makeOurCity/parking-status-sensor/hardware/lte-power-switch/renders/board-top.png

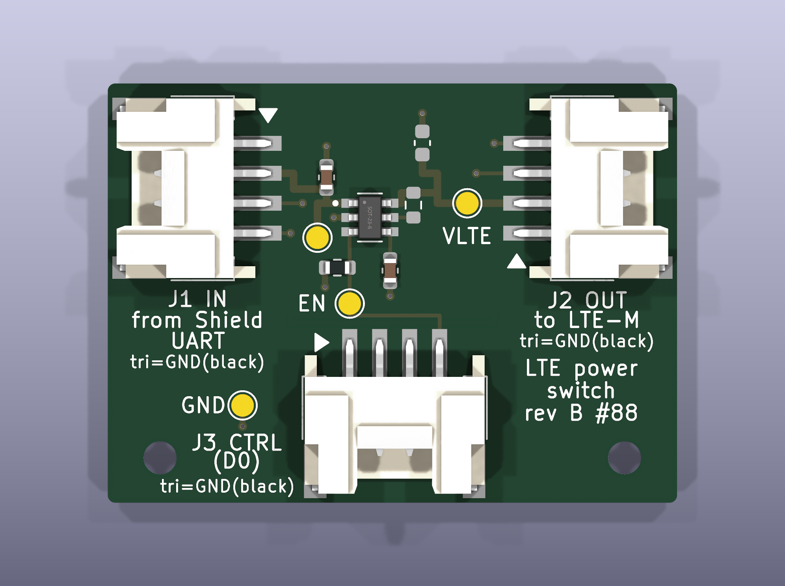
hardware/lte-power-switch/renders/board-top.png
