makeOurCity/parking-status-sensor/tools/ipad-sign-simulator/reference/full.png

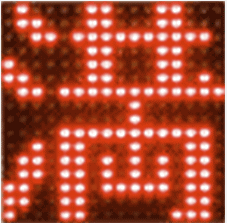
tools/ipad-sign-simulator/reference/full.png
