makeOurCity/parking-status-sensor/infra/README.md

# AWS IoT Core プロビジョニング（Issue #4）

[docs/iot-core.md](../docs/iot-core.md) の設計に沿って、IoT Core・Lambda スタブ・Cognito・LoRaWAN をセットアップするスクリプト群。

**組織の AWS アカウント**: この PoC 専用のアカウントに、これらのスクリプトで構築した（#98）。構成・必要な権限・権限の使い分け（確認は ReadOnly、作成は PowerUser、IAM ロールを作る手順は Admin）は [docs/aws-admin-handoff.md](../docs/aws-admin-handoff.md)。

## 前提

- [AWS CLI v2](https://docs.aws.amazon.com/cli/latest/userguide/getting-started-install.html)
- `jq`（`setup.sh` / `provision-device.sh` で使用）
- `zip`（`deploy-bridge-stub.sh` で使用）
- IAM 権限: IoT Core（Thing / Policy / Rule）、Lambda、IAM ロール作成、CloudWatch Logs

**アカウントの切り替え**: 開発者の個人 AWS アカウント（移行元。LTE-M 端末の切り替えまで残る）と組織アカウントは、`config.env` / `config.org.env` と `CONFIG_FILE` で切り替える。`EXPECTED_ACCOUNT_ID` が違えば何も作らずに中断する。

## 設定（`config.env`）

- **`EXPECTED_ACCOUNT_ID`（必須）**: 実行先の AWS アカウント ID（12 桁）。クレデンシャルが指すアカウントと違えば、すべてのスクリプトが何も作らずに中断する（旧アカウントと組織アカウントの取り違え防止、#98）
- **`AWS_PROFILE`（省略可）**: 未設定なら環境変数のクレデンシャルを使う。書き込み用（Power User）と確認用（ReadOnly）を使い分けるときは、`config.env` には書かず `AWS_PROFILE=<profile> ./verify.sh` のように実行時に渡す
- **`CONFIG_FILE`（環境変数）**: 設定ファイルを切り替える（相対パスは `infra/` から）。旧アカウントと組織アカウントを並べるとき: `CONFIG_FILE=config.org.env ./setup.sh`（`config.*.env` も Git 管理外）
- **`DEVICE_MASTER_TABLE` / `ORION_URL` / `ORION_FIWARE_SERVICE` / `ORION_FIWARE_SERVICEPATH` / `ORION_COGNITO_*`（省略可）**: Lambda の環境変数になる（#7）。`ORION_URL` が空なら Lambda は Orion に送らない。デプロイのたびに環境変数を `config.env` の内容で作り直すので、Orion の接続先を変えるときは `config.env` を直して `./deploy-bridge-stub.sh` を再実行する。Orion のトークンは有効期限があるため、Lambda が送るたびに Cognito（SRP。`USER_SRP_AUTH`）でログインして取る。`ORION_COGNITO_USER_POOL_ID` / `_CLIENT_ID` / `_USERNAME` / `_PASSWORD` の 4 つをそろえて設定する（`_CLIENT_SECRET` / `_TOKEN_TYPE` は省略可。リージョンは User Pool ID の先頭から決まる）。パスワードは `config.env` に書かず、`./deploy-bridge-stub.sh` の実行時に端末で入力するのを勧める（入力は画面に出ない。Lambda に設定済みの値があり、`USER_POOL_ID`・`CLIENT_ID`・`USERNAME` が同じなら、2 回目以降は入力不要で引き継ぐ。変えるときは `./deploy-bridge-stub.sh --ask-password`）。パスワードは Lambda の設定（環境変数）には入るので、Orion に書き込むだけの専用ユーザーにする。`./verify.sh` は設定済みかどうかだけを表示し、パスワードの値は出さない
- **`LOG_RETENTION_DAYS`（省略可。既定 400）**: Lambda のロググループの保持期間（日）。約 1 年。400 日は、iOS ログビューアのリセット時刻クエリが過去 400 日分を見ることに合わせた値で、CloudWatch Logs が受け付ける値のひとつ（365 なら 1 年ちょうど）。`setup.sh` がロググループ（無ければ作成）に設定し、`verify.sh` が確認する。空にすると設定しない（無期限）
- **`LAMBDA_ROLE_ARN` / `COGNITO_AUTH_ROLE_ARN` / `LORAWAN_ROLE_ARN`（省略可）**: IAM ロールを管理者が用意した場合の ARN。指定するとスクリプトはロールを作らず、そのロールを使う。Power User 権限では IAM ロールの作成も PassRole もできないため（#98）。ロールの定義は [docs/aws-admin-handoff.md](../docs/aws-admin-handoff.md)

## 手順

```bash
cd infra
cp config.env.example config.env   # EXPECTED_ACCOUNT_ID・リージョン等を編集
chmod +x *.sh lib.sh

./setup.sh                         # ポリシー + デバイスマスターのテーブル + Lambda + IoT ルール
./verify.sh                        # リソース確認
./provision-device.sh xiao-e83dc1fb05fc   # 端末1台分の Thing + 証明書
./test-publish.sh xiao-e83dc1fb05fc       # CLI から疎通確認
```

`provision-device.sh` は証明書を `firmware/certs/` に書き出し、`secrets.h` 用の設定値を表示する。

## スクリプト一覧

| スクリプト | 内容 |
|---|---|
| `setup.sh` | 一括セットアップ（ポリシー・ルール 2 本（端末テレメトリ / LoRaWAN）・Lambda）。何度実行しても同じ結果になる |
| `verify.sh` | セットアップ後のリソース存在確認 |
| `provision-device.sh` | Thing + 証明書を端末1台分登録 |
| `test-publish.sh` | AWS CLI からサンプルペイロードを publish |
| `deploy-bridge-stub.sh` | Lambda のみデプロイ（`bridge/` のモジュールを zip 化。Lambda の環境変数を `config.env` の `DEVICE_MASTER_TABLE` / `ORION_*` から設定。実行ロールには LoRaWAN 用 `iotwireless:GetWirelessDevice` とデバイスマスター用 `dynamodb:GetItem` を付与。`LAMBDA_ROLE_ARN` 指定時はロールを作らない（権限は管理者が付ける）） |
| `setup-device-master.sh` | デバイスマスター（deviceId → name / location）の DynamoDB テーブルを作る（#7, #14。プロビジョンド 1 RCU / 1 WCU）。`setup.sh` からも呼ばれる |
| `device-master.sh` | デバイスマスターの登録・確認・削除（`put <deviceId> <name> <lat> <lon> [--disabled]` / `list` / `get` / `delete`）。登録のない deviceId は Orion に書かれないので、`test-publish.sh` で Orion まで流したいときは先に `put` する |
| `setup-cognito.sh` | iOS ログビューアアプリ向け Cognito User Pool / Identity Pool / IAM ロール（CloudWatch Logs とデバイスマスターの読み取り専用）を一括作成（[docs/ios-app-cognito.md](../docs/ios-app-cognito.md)）。`--pools-only` で Identity Pool までで止め、管理者に渡すトラストポリシーを表示する。`COGNITO_AUTH_ROLE_ARN` 指定時はロールを作らず割り当てのみ |
| `verify-cognito.sh` | Cognito セットアップ後のリソース存在確認 |
| `setup-lorawan.sh` | IoT Core for LoRaWAN の `role`（Destination とゲートウェイが使う IAM ロール。IAM 権限が要る）、`profiles`（Service / Device Profile・Destination）、`gateway`（ゲートウェイ登録と CUPS 証明書。`--rotate` で再発行）、`device <deviceId>`（Wireless Device）。#98 |
| `verify-lorawan.sh` | LoRaWAN リソースの存在確認とゲートウェイの接続状態（読み取りのみ） |

`verify*.sh` は読み取り系の呼び出しだけなので、ReadOnly 権限のプロファイルで実行できる。

## LoRaWAN（Issue #40, #98）

[docs/40-lorawan-design.md](../docs/40-lorawan-design.md) の構成を、スクリプトで再現する。

```bash
./setup-lorawan.sh role                      # IAM ロール IoTWirelessGatewayCertManagerRole（IAM のロール作成と PassRole が要る権限で）
./setup-lorawan.sh profiles                  # Service Profile / Device Profile / Destination
./setup-lorawan.sh profiles --no-destination # ロール不要の Service / Device Profile だけ（Destination は後で）
./setup-lorawan.sh gateway                   # ゲートウェイ登録 + cups.{uri,trust,crt,key} を gateway-certs/ に出力
LORAWAN_DEV_EUI=<16桁> LORAWAN_APP_EUI=<16桁> \
  ./setup-lorawan.sh device <deviceId>       # AppKey は対話入力（履歴に残らない）
./verify-lorawan.sh <deviceId>
```

- Destination は IAM ロール（既定 `IoTWirelessGatewayCertManagerRole`）を使う。`role` で作れる（IAM 権限が要る。Power User では作れないので、その場合は管理者に作ってもらう）
- **ゲートウェイ EUI は他の AWS アカウントに登録済みだと作れない**。アカウント移行では、旧アカウントでゲートウェイを削除してから `gateway` を実行する
- `gateway-certs/` は Git 管理外。`cups.key` は秘密鍵で、再ダウンロードできない（紛失したら `gateway --rotate`）
- SenseCAP M2 側の設定（ローカルコンソール > LoRa > LoRa Network）は `gateway` の実行後に表示される手順に従う

## iOS ログビューアアプリ向け Cognito（Issue #68）

```bash
cd infra
./setup-cognito.sh     # User Pool + App Client + Identity Pool + IAM ロールを作成
./verify-cognito.sh    # リソース確認
```

`config.env` の `IOS_APP_USER_EMAIL` で指定したメールアドレスを Cognito ユーザー名として、ログイン用ユーザーを1名作成する（開発者本人のみ想定）。IAM ロールは `CLOUDWATCH_LOG_GROUP_NAME` で指定したロググループの読み取り専用に限定される。詳細設計は [docs/ios-app-cognito.md](../docs/ios-app-cognito.md) を参照。

## Basic Ingest

`config.env` の `USE_BASIC_INGEST=1`（デフォルト）で、端末は次のトピックへ publish する。

```
$aws/rules/parking_status_telemetry/parking-status/{deviceId}/telemetry
```

メッセージング課金を回避できる。詳細は [docs/iot-core.md](../docs/iot-core.md)。

## 関連 Issue

- [#4](https://github.com/makeOurCity/parking-status-sensor/issues/4) 接続基盤
- [#6](https://github.com/makeOurCity/parking-status-sensor/issues/6) ファームウェア TLS 対応
- [#7](https://github.com/makeOurCity/parking-status-sensor/issues/7) Lambda 本実装
