makeOurCity/parking-status-sensor/docs/schematic.md

# 回路図（Wi-Fi 第1弾）

Issue #11。試作1台の電気回路。部品表は [bom.md](bom.md)、組み立て手順は [wiring.md](wiring.md)。

- **図面種別**: 単線図 / 複線図 / 回路図
- **対象**: XIAO ESP32S3 + Grove Shield + Grove I2C Color Sensor V3.0 + LiPo
- **対象外**: LTE-M（Wi-Fi 不可現場で追加）、筐体（#14）
- **電圧**: DC 3.7 V（LiPo）→ Shield / XIAO 内蔵レギュレータ → DC 3.3 V 系統

---

## 図面記号・機器記号一覧

| 記号 | 機器 | 型番・備考 |
|---|---|---|
| BT1 | 二次電池（LiPo） | 3.7 V / 4,400 mAh、保護回路内蔵 |
| J1 | コネクタ | JST-PH 2.0（2極）、Grove Shield BAT 用 |
| J2 | コネクタ | Grove 4芯（Shield I2C ポート） |
| J3 | コネクタ | Grove 4芯（Grove Color Sensor V3.0 内蔵） |
| U0 | 拡張シールド | Grove Shield for XIAO（103020312） |
| U1 | マイコンモジュール | Seeed XIAO ESP32S3（U0 に装着） |
| U2 | カラーセンサモジュール | Grove I2C Color Sensor V3.0（VEML6040、I2C `0x10`） |
| C1 | 電解コンデンサ | 470 µF / 16 V |

端子名は XIAO・Shield・Grove モジュール実装のラベルに合拠する。Grove ケーブルは標準ピン配置のまま接続する（[wiring.md §3](wiring.md)）。

---

## 1. 単線図

系統と機能ブロックの関係。低圧 DC 電子機器としての単線表現。

```
                    ┌──────────────────────────────────────────┐
   情報系（論理）    │  [満空灯] → 光 → [U2 色検出]            │
                    │              ↑ I2C (Grove)              │
                    │    [U1+U0 判定・MQTT]                   │
                    │              │ Wi-Fi                    │
                    │              ↓                          │
                    │         [クラウド / FIWARE]              │
                    └──────────────────────────────────────────┘

                    ┌──────────────────────────────────────────┐
   電力系（物理）    │                                          │
                    │   BT1 ──→ U0（BAT・充電管理）──→ U1      │
                    │              │                            │
                    │              ├── 3.3 V 系統 ──→ U2       │
                    │              │         └── C1            │
                    │              └── USB-C（充電・開発用）    │
                    └──────────────────────────────────────────┘
```

| 系統 | 電圧・媒体 | 経路 |
|---|---|---|
| 主電源 | DC 3.7 V | BT1 → J1 → U0 BAT → U1 |
| 制御電源 | DC 3.3 V | U0/U1 LDO → 3V3 系統 → U2 |
| 通信（センサ） | I2C（Grove） | U0 I2C ↔ J2—J3 ↔ U2 |
| 通信（外部） | Wi-Fi 2.4 GHz | U1 内蔵アンテナ |

---

## 2. 複線図

全配線を線番で示す。Grove ケーブル内の線色は Seeed 標準（両端とも標準配置）。

| 線番 | 色 | 起点端子 | 終点端子 | 備考 |
|---|---|---|---|---|
| W1 | 赤 | BT1 (+) | J1-1 → U0 BAT+ | 極性確認必須 |
| W2 | 黒 | BT1 (−) | J1-2 → U0 BAT− | 同上 |
| W3 | 黄 | U0 I2C SCL | J2 → J3 → U2 SCL | Grove 標準 |
| W4 | 白 | U0 I2C SDA | J2 → J3 → U2 SDA | Grove 標準 |
| W5 | 赤 | U0 I2C VCC | J2 → J3 → U2 VCC | Grove 標準 |
| W6 | 黒 | U0 I2C GND | J2 → J3 → U2 GND | Grove 標準 |
| W7 | — | U0 3V3 | C1 (+) | Shield 近傍 |
| W8 | — | U0 GND | C1 (−) | 電解コンデンサ極性に注意 |

```
  BT1              J1          U0 (Shield)        J2    Groveケーブル    J3      U2
  ┌─┐            ┌─┴─┐    ┌─────────────┐       ┌─┴─┐   ═══════════   ┌─┴─┐  ┌────────────┐
  │+├─ W1 赤 ────┤ 1 ├────┤ BAT+        │       │黄 ├─ W3 SCL ────────┤黄 ├────┤ Grove SCL  │
  │-├─ W2 黒 ────┤ 2 ├────┤ BAT-        │       │白 ├─ W4 SDA ────────┤白 ├────┤ Grove SDA  │
  └─┘            └───┘    │ I2C Grove   │       │赤 ├─ W5 VCC ────────┤赤 ├────┤ Grove VCC  │
                            │  ┌─ U1 ─┐  │       │黒 ├─ W6 GND ────────┤黒 ├────┤ Grove GND  │
                            │  │XIAO  │  │       └───┘               └───┘  │ VEML6040   │
                            │  └──────┘  │                                   └────────────┘
                            │ W7   W8    │
                            └─┬────┬─────┘
                              │    │
                             ┌┴────┴┐
                             │  C1  │
                             │ 470µF│
                             └──────┘

  脱着点: J2 ↔ J3（Grove コネクタ）またはセンサパッチ全体
```

---

## 3. 回路図

電子回路としての接続。部品記号は一般的な回路図記法に準じる。

### 3.1 電源部

```
                        USB-C（開発・充電時）
                            │
                            ▼
    ┌───┐   W1    ┌───┐   ┌─────────────────────────────┐
    │   ├─────────┤ J1├───┤ BAT+          U0            │
    │BT1│   W2    │2P │   │ Grove Shield for XIAO       │
    │   ├─────────┤   ├───┤ BAT-                        │
    └───┘           └───┘   │  ┌─ 充電管理 ─┐           │
     3.7V                    │  │    U1 XIAO ESP32S3    │
                             │  └──────┬─────┘           │
                             │         │ 3.3V LDO        │
                             │        ┌┴┐                │
                             │    3V3 ┤   ├───────────┬───┼──→ W5 (3.3V 系統)
                             │        └┬┘           │   │
                             │         │            │   │
                             │       GND├────────────┼───┼──→ W6 (GND 系統)
                             └─────────┼────────────────┘
                                       │
                                      ⊥ GND

    3.3V 系統 ──┬── W5 ──────────────────────────→ （後段 U2 へ）
                │
               ┌┴┐
               │ │ C1  470µF / 16V  （W7, W8）
               └┬┘
                │
               GND
```

### 3.2 I2C センサ部（U2）

```
    3.3V 系統 ──── W5 ────┬── U2 VCC
                          │
                         ┌┴┐  （U2 基板内蔵: バイパス、
                         │ │   I2C プルアップ抵抗）
    GND ──────── W6 ─────┴── U2 GND

    U0/U1 SDA (D4) ── W4 ── U2 SDA ──┐
                                      ├── I2C バス
    U0/U1 SCL (D5) ── W3 ── U2 SCL ──┘
                                      アドレス: 0x10
```

### 3.3 統合回路図

```
                                    ┌─────────────────────────────────┐
                                    │  U0 Grove Shield + U1 XIAO      │
    ┌───┐      ┌───┐                  │                                 │
    │BT1├─W1W2─┤J1 ├─────────────────┤ BAT+ / BAT-                    │
    └───┘      └───┘                  │                                 │
     3.7V                             │  I2C Grove ── W3〜W6 ────┐     │
                                      │  3V3 ─────┬──── W5 ──┐ │     │
                                      │  GND ─────┼──── W6 ──┐│ │     │
                                      │             │  C1   ││ │     │
                                      │             │ 470µF ││ │     │
                                      │             └──┬────┘│ │     │
                                      └──────────────────┼─────┼─┼─┘
                                                         │     │ │
                        ┌───┐   Grove 4芯      ┌───┐   │     │ │
                        │J2 ├─── W3〜W6 ────────┤J3 ├───┘     │ │
                        └───┘   (50〜100cm)    └─┬─┘         │ │
                                                 │ 脱着      │ │
                                                 ▼           ▼
                        ┌─────────────────────────────────────┴──┐
                        │  U2  Grove I2C Color Sensor V3.0         │
                        │  (VEML6040, Grove コネクタ内蔵)         │
                        └──────────────────────────────────────────┘
```

---

## 4. 端子台帳

### U0: Grove Shield for XIAO（使用端子）

| 端子 | 接続 | 線番 |
|---|---|---|
| BAT+ | J1-1 ← BT1 (+) | W1 |
| BAT− | J1-2 ← BT1 (−) | W2 |
| Grove I2C（黄） | SCL → U2 | W3 |
| Grove I2C（白） | SDA → U2 | W4 |
| Grove I2C（赤） | 3.3 V → U2 VCC | W5 |
| Grove I2C（黒） | GND → U2 | W6 |
| 3V3 | C1 (+) | W7 |
| GND | C1 (−) | W8 |

### U2: Grove I2C Color Sensor V3.0（使用端子）

Grove 標準ピン配置（J3 内蔵コネクタ）:

| Grove ピン | 線色 | 信号 | 線番 |
|---|---|---|---|
| 1 | 黄 | SCL | W3 |
| 2 | 白 | SDA | W4 |
| 3 | 赤 | VCC | W5 |
| 4 | 黒 | GND | W6 |

---

## 5. 設計メモ

| 項目 | 内容 |
|---|---|
| I2C アドレス | VEML6040: `0x10`（ファーム・スキャン時の確認値） |
| センサ出力 | R / G / B / W。MQTT・NGSIv2 の `clear` は W に対応 |
| Grove 配線 | ピン入替不要（旧 TCS34725 基板＋L字コネクタ構成から簡素化） |
| ファームウェア | VEML6040 ドライバ（`firmware/src/sensor.cpp`、Issue #5） |

詳細は [hardware.md](hardware.md)・[firmware/README.md](../firmware/README.md) を参照。
