makeOurCity/parking-status-sensor/hardware/lte-power-switch/renders/board-bottom.png

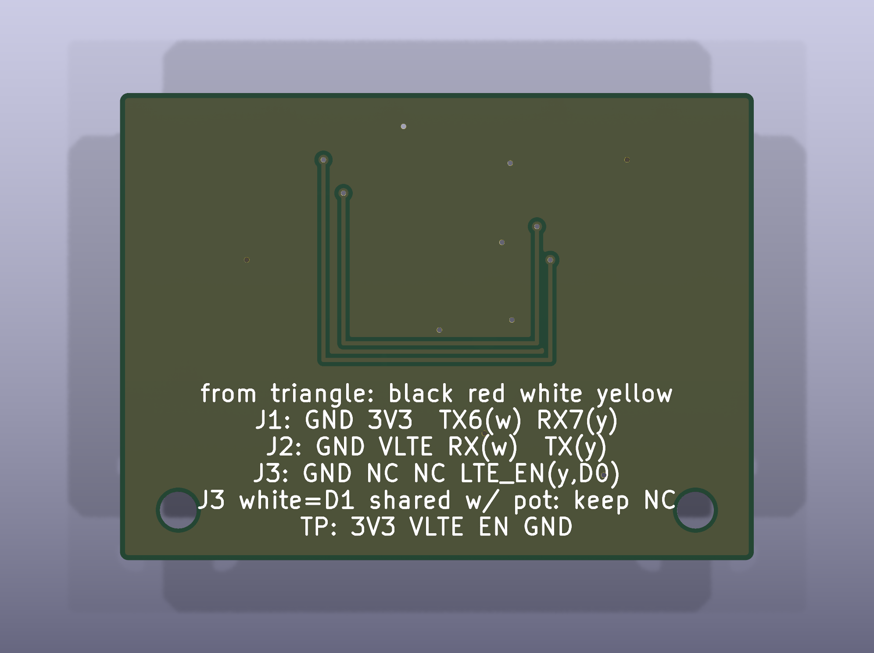
hardware/lte-power-switch/renders/board-bottom.png
