makeOurCity/parking-status-sensor/tools/ipad-sign-simulator/reference/empty.png

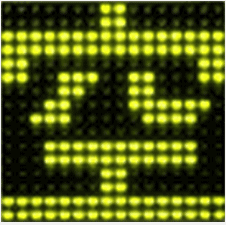
tools/ipad-sign-simulator/reference/empty.png
