makeOurCity/parking-status-sensor/docs/bom.md

# 詳細BOM（試作1台分）

Issue #11 のドラフト。Wi-Fi 第1弾 PoC 向けの部品リスト。

- **対象**: 試作1台。現場設置（LiPo・Grove センサ延長・黒シート積層固定）まで見据える
- **通信**: Wi-Fi のみ（LTE-M モジュール・SORACOM SIM は今回対象外）
- **電源**: LiPo 単体運用（自宅・オフィス等の既知 Wi-Fi でまず動作確認）
- **筐体**: 防水ケース・ケーブルグランドは #12（実寸確認後）

部品選定の経緯・将来の LTE-M 構成は [hardware.md](hardware.md) を参照。回路図は [schematic.md](schematic.md)、組み立て手順は [wiring.md](wiring.md)。

---

## 手持ち・キット類（棚卸し予定）

### Raspberry Pi センサーキット（未開封の可能性あり）

過去に購入した Raspberry Pi 向けセンサー・ケーブル等のまとめキットが手元にある見込み。箱の中身はこれから確認する。

キットに含まれていれば、本 BOM の以下と**重複する可能性**がある（あれば購入分は不要）:

- ジャンパ線（オス-メス / オス-オス）… DevKit ベンチ用
- ピンヘッダー・ブレッドボード
- その他汎用センサー（本 PoC では未使用）

重複があっても問題ない。余剰分はデバッグ用に使う。

### その他、手持ちで足りるもの

| 品目 | 用途 |
|---|---|
| USB-C データケーブル | 書き込み・デバッグ・LiPo 充電 |
| 熱収縮チューブ・ビニールテープ | 絶縁・JST はんだ箇所の strain relief |
| テスター | LiPo JST 極性確認、Grove ケーブル導通確認 |
| はんだごて・はんだ | JST・470µF 付け（センサモジュールへのはんだ不要） |

---

## 1. 電子部品

| # | 部品 | 型番・品番 | 数量 | 入手先 | 価格 | 備考 |
|---|---|---|---|---|---|---|
| 1 | マイコン | Seeed XIAO ESP32S3（無印）M-18078 | 1 | [秋月電子](https://akizukidenshi.com/catalog/g/gM-18078/) | ¥1,480 | ピンヘッダー非同梱。BAT はパッドのみ |
| 2 | Grove Shield | Grove Shield for XIAO 103020312 | 1 | [Seeed JP](https://jp.seeedstudio.com/Grove-Shield-for-Seeeduino-XIAO-p-4621.html) 等 | 約¥700 | I2C×2・UART×1・BAT パッド付き |
| 3 | カラーセンサ | Grove - I2C Color Sensor V3.0（101021133） | 1 | [Seeed Studio](https://www.seeedstudio.com/Grove-Color-Sensor-V3-0-p-5993.html) 等 | 約¥600 | VEML6040 搭載。Grove コネクタ内蔵 |
| 4 | バッテリー | LiPo 3.7V 4,400mAh JST-PH #15095 | 1 | [ストロベリーリナックス](https://strawberry-linux.com/catalog/items?code=15095) | ¥550 | 保護回路内蔵。接続前に極性確認 |
| 5 | 電解コンデンサ | 470μF 16V 16WXA470MEFC8X9 | 1 | [秋月電子](https://akizukidenshi.com/catalog/g/g108426/) | ¥10 | Wi-Fi 送信時の電圧降下対策。3V3-GND 間 |
| 6 | ピンヘッダー 1×40 | PH-1x40SG | 1 | [秋月電子](https://akizukidenshi.com/catalog/g/g100167/) | ¥35 | XIAO 用。14ピン分を切り出してはんだ付け（Shield 装着用） |
| 7 | JST-PH 2.0 メス + リード | PH2pin AWG24 約10cm 等 | 1 | [Amazon 等](https://www.amazon.co.jp/dp/B091JQS7BB) | ¥数百 | **Grove Shield BAT パッド**用。**2pin 版**を選ぶ |

### 今回対象外（将来・README 設計どおり）

| 部品 | 備考 |
|---|---|
| M5Stack SIM7080G CAT-M Unit（M5STACK-U128） | Wi-Fi 不可現場が出た時点で調達。Grove UART 接続 |
| SORACOM IoT SIM plan-D / plan-KM1 | 同上。動作確認済み |

---

## 2. 配線・コネクタ（Grove 統一）

### 2.1 センサ接続（Grove I2C）

XIAO + Grove Shield とセンサパッチ（Grove Color Sensor V3.0 + 黒シート積層）を **Grove 4芯ケーブル1本**で接続する。

| # | 部品 | 型番・品番 | 数量 | 入手先 | 価格 | 備考 |
|---|---|---|---|---|---|---|
| 8 | Grove 4芯ケーブル | 50cm / 100cm 等 | 1 | Seeed / Amazon 等 | 約¥200〜400 | 現場ごとに長さを選択。ピン入替不要 |

**Shield 側・センサ側とも** Grove 標準ピン配置のまま接続する（[wiring.md](wiring.md) §3）。

### 2.2 ジャンパ線（470µF 仮接続用・任意）

| # | 部品 | 数量 | 入手先 | 価格 | 備考 |
|---|---|---|---|---|---|
| 9 | ブレッドボード用ジャンパ線（オス-メス）15cm | 1パック | [秋月 103472](https://akizukidenshi.com/catalog/g/g103472/) | ¥330 | 470µF 仮接続用。Pi キットにあれば不要 |

**センサ延長は Grove ケーブルのみ。** ジャンパ線は 470µF 仮接続等に限定する。

## 3. 機構・その他

| # | 部品 | 数量 | 入手先 | 備考 |
|---|---|---|---|---|
| 11 | 透明テープ | 1 | ホームセンター / 100均 | 発光面全面固定（落下防止） |
| 12 | 黒カッティングシート | 1 | ホームセンター / 100均 | 遮光層。受光窓を切り抜く |
| 13 | 結束バンド | 適量 | ホームセンター | 配線整理 |

### #14 で扱う（今回の詳細BOMでは未確定）

| 部品 | 備考 |
|---|---|
| 防水ケース（IP65以上） | LiPo・Shield の実寸確認後に選定 |
| ケーブルグランド（M12/M16） | ケース選定と同時 |

---

## 4. 組み立て前チェックリスト

- [ ] Raspberry Pi センサーキットの棚卸し（重複部品の確認）
- [ ] XIAO にピンヘッダー（14ピン分）をはんだ付け
- [ ] XIAO を Grove Shield に装着
- [ ] Grove Shield の **BAT パッド**に JST-PH メスをはんだ付け（極性確認済み）
- [ ] LiPo を JST で接続し、USB 非接続で起動するか確認
- [ ] 黒カッティングシートに受光窓を切り、Grove Color Sensor V3.0 をセンサパッチとして貼付
- [ ] Grove ケーブルで Shield I2C ↔ センサを接続し、導通を確認
- [ ] 470µF を 3V3-GND 間に接続（はんだ付け推奨。ジャンパ仮接続でも可）

---

## 5. 費用見積（Wi-Fi 第1弾）

上記 #1〜#9 をすべて新規購入した場合の目安（ホームセンター品・手持ち工具は除く）。

| 区分 | 金額 |
|---|---|
| 電子部品（#1〜7） | 約 ¥3,400 |
| Grove 配線（#8） | 約 ¥400 |
| ジャンパ線（#9・任意） | 約 ¥330 |
| **試作1台 合計** | **約 ¥4,100** |

※ LTE-M モジュール・SIM を除く。README の約1.4〜1.5万円は LTE-M 込みの全体設計見積。Pi キットや手持ち部品で賄える分は上記から差し引く。

---

## 6. 未決事項（#14 へ）

- 防水ケースの具体型番・内部レイアウト
- ケーブルグランドのサイズ・個数
- LiPo 単体運用時の長期 Wi-Fi 送信における電源余裕の実測
- Raspberry Pi センサーキットの具体的な型番・同梱物リスト（棚卸し後に追記）
