makeOurCity/parking-status-sensor/hardware/lte-power-switch/fabrication/lte-power-switch-bom.csv

Comment | Designator | Footprint | LCSC Part #
TPS22918DBVR | U1 | SOT-23-6 | C131941
HY2.0-4P-WT | J1,J2,J3 | HY2.0-4P-WT_SMD-RA | C722729
1uF | C1 | C_0603_1608Metric | C15849
1nF | C2 | C_0603_1608Metric | C1588
100k | R1 | R_0603_1608Metric | C25803
