makeOurCity/parking-status-sensor/hardware/flame-sensor-case/grove-flame-sensor-case.3mf

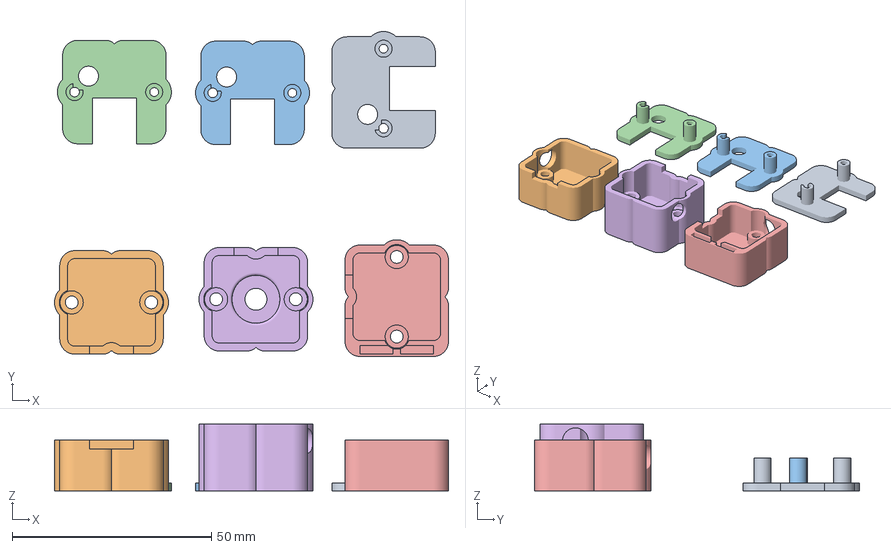
[picture p5: CAD file, 2026-10-07]
hardware/flame-sensor-case/grove-flame-sensor-case.3mf
99.0 x 81.6 x 16.8 mm
