makeOurCity/parking-status-sensor/docs/91-lorawan-failure-and-power.md

# Issue #91: LoRaWAN 版の失敗時の制限時間・バックオフと、消費電力の実測

対象Issue: https://github.com/makeOurCity/parking-status-sensor/issues/91

**種類: 作業記録ドキュメント（暫定・WIP）。** 途中経過は、まず #91 の Issue コメントに書き、区切りができたらこのファイルに反映して PR にする（AGENTS.md「ドキュメント運用」）。ファームの変更は本 PR に含めない（§4）。

## 1. 静的に読んだ内容の確認（2026-10-02、`main` = 0187a1c）

Issue 本文の「静的に読んだ結果」を、コードで確認した。実機での確認ではない。

| 項目 | 確認結果 | 該当箇所 |
|---|---|---|
| 接続フェーズの制限時間 | 各試行の**開始前**にしか確認しない。Join の最大待ち時間は固定で、残り時間では縮まらない | `transport.cpp` `connectTransportWithRetry`、`connectLoRaWan`、`wio_e5.cpp` `wioE5Join` |
| publish フェーズの制限時間 | 試行の開始前にしか確認しない。再 Join と送信のタイムアウトは固定 | `main.cpp` `publishWithRetry`、`reconnectTransport` → `connectLoRaWan` |
| Wio-E5 無応答時 | `wioE5Wake` は既定で 5 回 × 300ms = 約 1.5 秒で失敗する。`wioE5Join` と `wioE5SendConfirmedHex` は、それぞれ先頭で `wioE5Wake` を呼ぶ | `wio_e5.cpp` |
| バックオフ | なし（`ledgerRecordFailure` に記録するのみ） | `main.cpp` |
| `AT+RESET` | ファームに実装なし | `wio_e5.cpp` |

結論: Issue 本文の経路（接続に約 50 秒かけたあと、publish で再 Join と送信が重なり WDT の 80 秒を超える）は、コード上は成立する。ただし起こる確率は低く、実機で再現はしていない。

## 2. #87 との関係

- `fix/87-lte-modem-silent-watchdog-loop` には**設計書（`docs/87-lte-modem-silent-design.md`）だけ**があり、実装と PR はまだない（2026-10-02 時点）。
- #87 の設計では、`transport.h` に `deadlineAfter()` を置き、`connectTransport` などに hard deadline を渡す。`task_wdt` 起動のサイクルは送信せず失敗として記録する。バックオフは #89 の担当。
- そのため、#91 のファーム変更（LoRaWAN の Join・再 Join・送信の待ち時間の clamp）は、#87 の実装が入ってからその仕組みに載せて別 PR で行う。

## 3. 消費電力の実測（U200-1A）

方法: [power-measurement.md](power-measurement.md)、[tools/power-logger/README.md](../tools/power-logger/README.md) の**高速モード**（`logger-devkit-fast`）。LiPo → U200 IN/OUT → Grove Shield BAT、USB 非接続。

### 3.1 記録する個体情報

| 項目 | 記入 |
|---|---|
| 実施日 / 実施者 | 2026-10-02 / SAKAI Kazuki |
| 個体（デバイス ID） | |
| ファームの env | `xiao-s3-lorawan-pot`（実施者の申告。書き込んだ env は未確認。ログのどこかでブートログを確認できれば照合する） |
| ポットの接続 | 13:58:15 頃まで接続あり、以降は抜いた（ログの待機電流の段差から読んだ時刻、±数秒）。同じ 1 本のログ内で前後を比較した |
| LiPo の個体番号 / 開始時の電圧 | #1 / 約 4.07 V（ロガーの値） |
| Wio-E5 のファーム | 4.0.11（docs/40 で確認済み。要再確認） |
| ゲートウェイとの距離・環境 | |
| 電源投入の時刻（ログとの対応） | 13:22 頃（推定。ブートモード中の約 43 mA が 13:26 頃までに終わった観測から、約 4 分を引いた値）。ご自身の取得は 13:28 開始。取得したログは、ブートモード終了後の Deep Sleep 以降。Join と最初の送信は入っていない |

**ポットの影響（注意）:** docs/60 §10 の実測では、ポットを常時接続したままだと LTE-M 版の Deep Sleep 待機電流が 0.45 → 0.75 mA に増えた。LTE-M 版はリレーでポットの電源を切る構成（docs/60 §11）で、LoRaWAN 版はリレーを使わないため、ポットがつながっていれば常に給電される。`-pot` の値はブートモード中に NVS へ保存されるので、ブートモード終了後はケーブルを抜いても動作は変わらない。待機電流を測る目的では、**ポットをつないだ状態と外した状態の両方**を測るか、どちらで測ったかを記録する。

### 3.2 取りたい値（Issue の未測定項目に対応）

| 項目 | 値 | 出所（ログのどの区間か） |
|---|---|---|
| Deep Sleep 中の電流（ポットあり） | **0.847 mA**（中央値 0.81） | 13:28〜13:58 の約 28.7 分 |
| Deep Sleep 中の電流（ポットなし） | **0.487 mA**（中央値 0.43） | 13:58:30〜14:15 の約 16.1 分 |
| 起床だけで送信しないサイクル 1 回の mAh（Deep Sleep 分を除く） | **0.053 mAh**（0.052〜0.054、n=5） | 約 5.2 秒、約 36 mA が約 4.5 秒続く |
| 送信 1 回（Join 済み、ACK あり。状態を変えて起こした送信）を含む起床サイクルの mAh | **0.073 mAh**（0.071〜0.074、n=4） | 約 6.7 秒。送信なしより約 1.5 秒長く、その間約 45〜48 mA |
| 送信そのものの上乗せ | 約 0.020 mAh | 上の差（0.073 − 0.053） |
| Join 1 回の mAh（電源投入直後。プロビジョニングと最初の送信を含む） | 約 0.016 mAh（ブートモードの待機 43.3 mA を超える分） | §3.4。電源投入から最初の送信まで約 14 秒、最大 109 mA。再 Join と失敗時は未測定 |
| `disconnectTransport()` の `AT+LOWPOWER`（Wio-E5 を起こすコスト）の mAh | **未測定**（起床サイクルの 0.053 mAh に含まれる。内訳は分けられていない） | |
| 1 日あたりの mAh と電池日数（LiPo 3,960 mAh） | 下の §3.3 | |

試算（#40 コメント）は、送信 1 回 0.08 mAh を仮定した机上値で、平常約 148 日、最悪約 112 日。この実測では、**送信そのものは約 0.02 mAh と小さく、送信しない起床サイクルの 0.053 mAh（約 4.5 秒の約 36 mA）が支配的**だった。試算の内訳は未確認なので、比較は本文では行わない。

### 3.3 結果

条件: `xiao-s3-lorawan-pot`、LiPo #1（約 4.07 V、最低 4.018 V）、Deep Sleep あり、電源投入から約 6 分後に取得開始（13:28:20）、取得 46.9 分、起床サイクル 9 回（送信なし 5、送信あり 4）。送信ありは、実施者が満空の状態を変えて起こした送信（14:01 を含む 4 回で、実施者の確認済み）。heartbeat（約 1 時間）は取得時間内に来ていない。

| 項目 | ポットあり | ポットなし |
|---|---|---|
| Deep Sleep 中の電流 | 0.847 mA | 0.487 mA |
| 起床（送信なし）1 回 | 0.053 mAh | 0.053 mAh |
| 起床（送信あり）1 回 | 0.073 mAh | 0.073 mAh |
| 1 日（5 分周期、heartbeat 24 回、他の送信なし） | 約 36.1 mAh | **約 27.5 mAh** |
| 電池日数（3,960 mAh、自己放電と電圧低下による使えない領域は未考慮） | 約 110 日 | **約 144 日** |

1 日の内訳（ポットなし）: Deep Sleep 約 11.7 mAh（0.487 mA × 24 h）、起床 約 15.3 mAh（0.0531 × 288）、heartbeat の送信上乗せ 約 0.5 mAh（0.0197 × 24）。

- ポットを抜くと、待機電流が約 0.36 mA 下がる（docs/60 の LTE-M 版の実測 約 0.3 mA とほぼ一致）。起床サイクルの電荷は、ポットの有無で変わらない。
- 待機電流の平均が中央値より高いのは、ときどき数 mA の山が混ざるため（ポットなしで 0.487 vs 0.43）。電池日数には平均を使った。
- 起床の周期（約 305 秒）から外れた、13〜18 mA の山が 1 窓（50 ms）だけ出る事象が 4 回あった（13:34、13:50、14:09、14:10）。電荷はほぼ 0 で、原因は不明。

**限界（結論の範囲）:**

- 1 個体、1 本の LiPo、約 47 分。電池の消耗による変化は見ていない。
- 送信は、Join 済みの送信と、電源投入直後の Join（§3.4）だけ。再 Join、失敗時（ACK なし、ゲートウェイ圏外）の電流は取れていない。
- 起床の約 4.5 秒、約 36 mA の内訳は、ログだけからは分からない。コードの待ち（`waitForSerial` の最大 3,000 ms と、`initSensor` の `delay(1500)`）の合計と時間が一致するので、これが原因と推定した。電池駆動では `Serial` が真にならず、毎回 3 秒を使い切る。このうち `waitForSerial` の 3 秒は、#94 の実機測定（§3.4）で、外すと起床が約 3 秒短くなることを**確認した**。`initSensor` の `delay(1500)` は、残った約 1.5 秒の平らな区間と一致するが、まだ変更して測っていない。対応と検証は #94。

### 3.3.1 暫定の観測（記録の経緯）

取得開始前にロガーの画面出力を数秒だけ読み取った値: ブートモード中（電源投入から約 4 分は Deep Sleep しない）は約 43.5 mA（約 4.05 V）、ブートモード終了後は約 0.83 mA だった。後者は、上の「ポットあり」の値とほぼ同じ。

### 3.4 #94 の検証: `waitForSerial` を外した後の測定（2026-10-02）

条件: `xiao-s3-lorawan-pot`、ポットなし、`waitForSerial` だけを変更したファーム（変更内容と PR は #94 を参照）。ログ取得を先に始めてから電源を入れた（電源投入 14:49:51、取得 14:49:46〜15:09:58 の約 20 分）。電源投入直後の電圧は約 4.07 V。満空の状態を 14:54、14:59、15:04 に変えた（時刻は多少前後する）。LiPo の個体は未確認。

**起床サイクル（送信あり。3 回）**

| 項目 | 変更前（§3.2、n=4） | 変更後（n=3） | 差 |
|---|---|---|---|
| 長さ | 6.7 s | 3.8 s | −2.9 s |
| 電荷（Deep Sleep 分を除く） | 0.0728 mAh（0.0712〜0.0735） | 0.0437 mAh（0.0436〜0.0438） | −0.029 mAh（−40 %） |
| 約 36 mA の平らな区間 | 約 4.5 s | 約 1.5 s | −3.0 s |

- 見積り（−3.0 s × 36.5 mA = −0.030 mAh）と、実測の差（−0.029 mAh）は約 4 % 以内で一致した。
- Deep Sleep は 0.489 mA（約 15.6 分、変更前 0.487 mA）で変化なし。
- 残った約 1.5 秒の平らな区間は、`initSensor` の `delay(1500)` と推定（未検証）。
- 送信なしの起床は、この測定では取れなかったため、下の追加測定で取った。

**起床サイクル（送信なし。追加測定、15:12:12〜15:25:17 の約 13 分、同じファーム、状態は変えず、起床 3 回）**

| 項目 | 変更前（§3.2、n=5） | 変更後（n=3） | 差 |
|---|---|---|---|
| 長さ | 5.2 s | 2.2 s | −3.0 s |
| 電荷（Deep Sleep 分を除く） | 0.0531 mAh | 0.0243 mAh（0.0242〜0.0244） | −0.029 mAh（−54 %） |
| 約 36 mA の平らな区間 | 約 4.5 s | 約 1.5 s | −3.0 s |

- 見積り（約 0.024 mAh、2.2 s）と一致した。Deep Sleep は 0.493 mA（約 12.8 分）で、変化なし。
- 送信なしのサイクルは、送信ありにある約 2 秒の約 45 mA の区間が無く、約 1.5 秒の約 36 mA の後に、約 0.7 秒の約 43〜53 mA（Wio-E5 を起こして `AT+LOWPOWER`）で終わる。
- 状態を変えなかったので、3 回とも送信なし。heartbeat（電源投入から約 1 時間）は取得時間内に来ていない。

**1 日の電荷と電池日数（ポットなし、5 分周期、heartbeat 24 回、他の送信なし）**

| | 起床（送信なし） | 起床（送信あり） | 1 日 | 電池日数（3,960 mAh） |
|---|---|---|---|---|
| #94 前（実測） | 0.0531 mAh | 0.0728 mAh | 約 27.5 mAh | 約 144 日 |
| `waitForSerial` 後（実測） | 0.0243 mAh | 0.0437 mAh | 約 19.2 mAh | 約 206 日（約 +43 %） |

- 内訳（`waitForSerial` 後）: Deep Sleep 約 11.8 mAh（0.49 mA × 24 h）、起床 約 7.0 mAh（0.0243 × 288）、heartbeat の送信上乗せ 約 0.5 mAh（0.0194 × 24）。
- 自己放電と、電圧低下による使えない領域は未考慮。heartbeat そのもの（約 1 時間後の送信）は未測定で、送信上乗せは、送信ありと送信なしの差から出した。

**次の候補（未検証、#94）**

| 候補 | 1 日あたりの削減見込み | 日数の見込み |
|---|---|---|
| `initSensor` の `delay(1500)`（約 1.5 秒、約 0.015 mAh/回） | 最大 約 4.4 mAh | 約 267 日 |
| 送信なしのサイクルでも毎回行う `AT+LOWPOWER`（尾の約 0.7 秒、約 0.009 mAh/回） | 最大 約 2.5 mAh | さらに延びる。ただし Deep Sleep 復帰時の ROM ログで Wio-E5 が起きるのを防ぐ処理（docs/40）なので、設計の確認が要る |
| Deep Sleep の 0.49 mA（今は 1 日の約 6 割） | 内訳は未分解 | |

**電源投入直後の Join**

| 項目 | 値 |
|---|---|
| 電源投入から最初の送信まで | 約 14 秒（約 13 秒に最大約 109 mA の山） |
| Join、プロビジョニング、最初の送信の超過電荷（ブートモードの待機 43.3 mA を除く） | 約 0.016 mAh |
| ブートモード中の 2 回目以降の送信の超過電荷 | 約 0.002〜0.007 mAh |
| ブートモード全体（246.5 秒） | 2.97 mAh（平均 43.4 mA） |

- Join 自体の電荷は小さい。電源投入後の電池への負担は、約 4 分のブートモードの待機（約 43 mA）のほうが大きい。
- Join は電源投入時とプロビジョニング時だけなので、通常運用の電池日数にはほぼ影響しない。
- 圏外で Join を最大 3 回試すケース（#91 の最悪ケース）は未測定。

### 3.5 解析手順

```bash
cd tools/power-logger
python3 integrate_mah.py capture-fast-YYYYMMDD-HHMM.csv   # 区間の mAh
python3 find_dips.py capture-fast-YYYYMMDD-HHMM.csv       # 起床サイクルごとの最低電圧・最大電流
```

- **注意:** `pio device monitor` で途中から取ったログには、先頭の `ms,samples,…` のヘッダー行が入らない。`integrate_mah.py` はヘッダーが無いと電流列を 2 列目（`samples`、約 108）と見なし、今回の途中経過（25.6 分）では 44.9 mAh と、実際（約 0.68 mAh）の 60 倍以上の**誤った値を出した**。ログの先頭に `ms,samples,bus_min_mV,bus_avg_mV,current_max_mA,current_min_mA,current_avg_mA` の行を足してから実行するか、7 列のログを見て `current_avg_mA` 列を選ぶようにスクリプトを直す（今回の数値は、`current_avg_mA` 列を 50 ms ごとに直接積算して出した）。
- 起床サイクルは 5 分ごと。heartbeat（送信）は 12 サイクル = 約 1 時間ごと。1 時間後の送信までを含めるには、**約 75 分以上**の記録が要る。
- 電源投入直後の Join（約 6 秒）と最初の送信を取るには、**ロガーを動かしたまま XIAO の電源を入れ直す**。
- 生の CSV は大きいので、リポジトリには入れず、要約（表）と必要な区間の抜粋だけを `tools/power-logger/results/` に置く（既存の慣例）。

## 4. ファームの対応案の扱い

| 対応案（Issue） | 扱い |
|---|---|
| 制限時間を LoRaWAN 経路にも適用 | #87 の実装後に、その仕組みに載せて別 PR |
| 連続失敗時のバックオフ | #89 と共通の仕組みにできるか、#89 の設計を見てから決める |
| WDT 起動サイクルを送信せず失敗として記録 | #87 の `runCycle` 共通の実装が入ったあと、LoRaWAN env で動作を確認する |
| Wio-E5 無応答時の復旧手段（`AT+RESET` など） | ハング例が観測されてから検討する |
| #40 の未測定項目の実測 | §3 |
| 起床サイクルの待ち（`waitForSerial` 3 秒、センサー 1.5 秒）の短縮 | #91 の範囲外。#94 で扱う |

## 5. 未確認

- Deep Sleep 中の GPIO43（TX）で Wio-E5 が起きないか（docs/40 §7）。ログの Deep Sleep 区間に、周期的な小さな山がないかで確認する。
- `AT+LOWPOWER` 時の Wio-E5 の消費電流。モジュール単体のデータシート値は 2.1µA、Grove 基板として Wiki は 60µA（Issue 本文）。実測で置き換える。
- 実設置先でのゲートウェイの設置可否と到達性。

## 関連

#87、#89、#94（起床サイクルの待ちの短縮）、#40、#46、#47、#74
