makeOurCity/parking-status-sensor/hardware/lte-power-switch/lte-power-switch-schematic.pdf

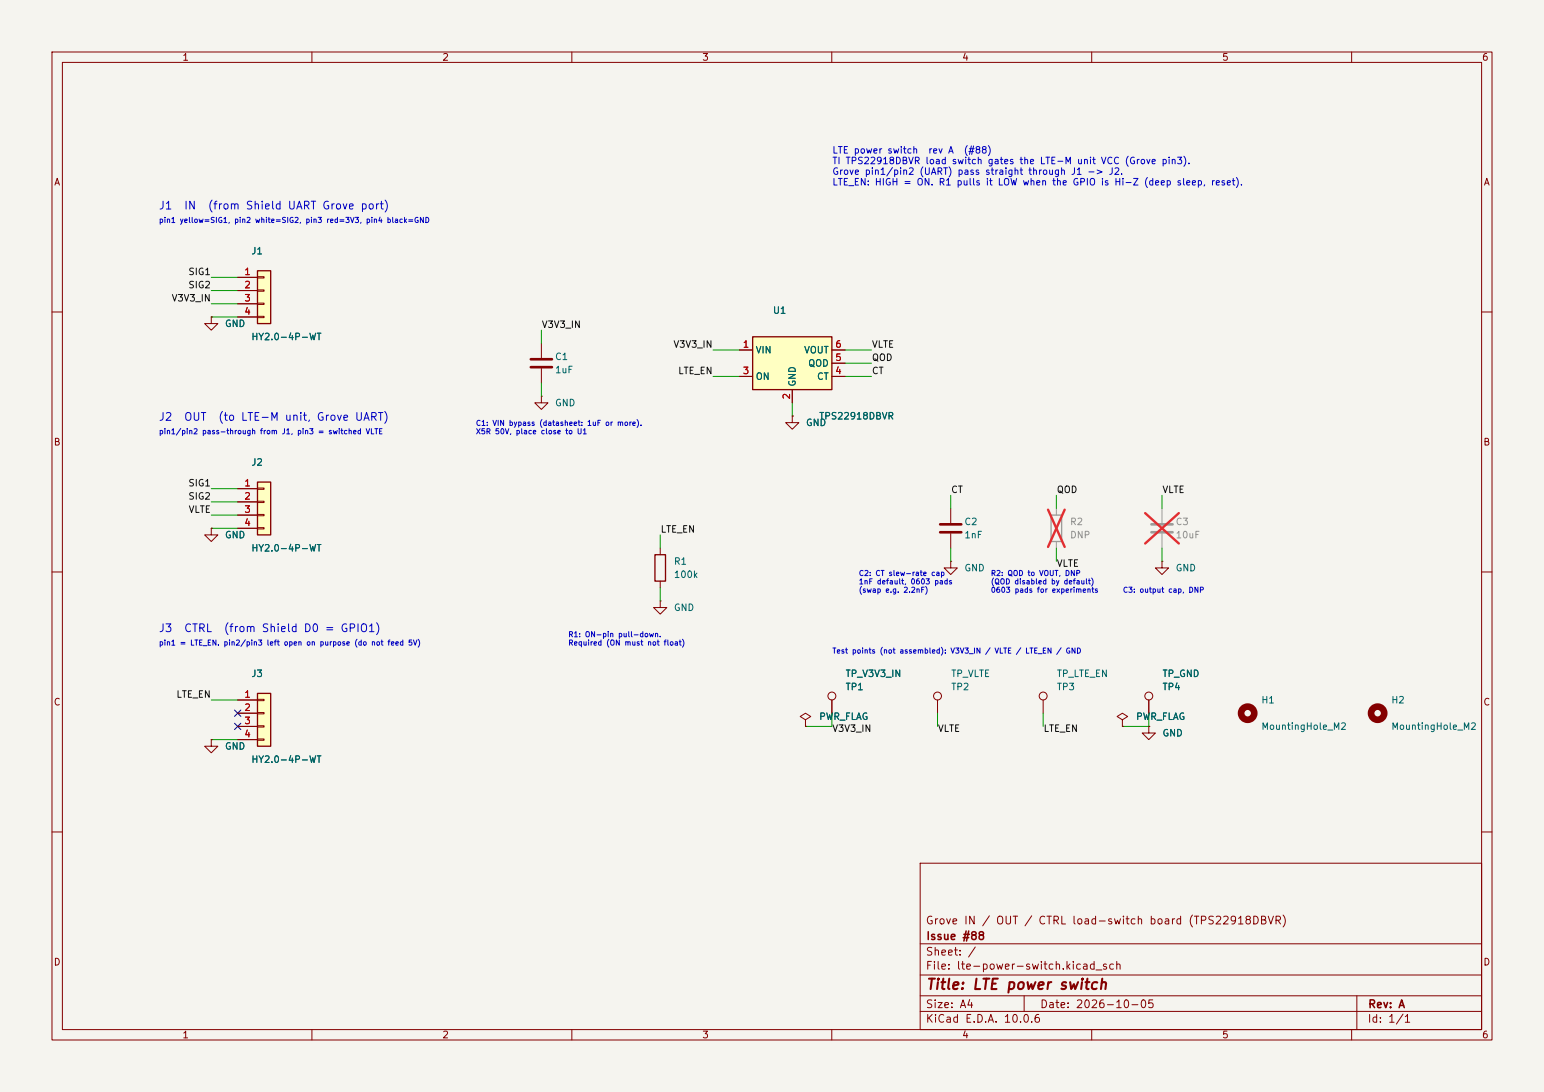
[picture p6: page 1]

LTE power switch rev A (#88) TI TPS22918DBVR load switch gates the LTE-M unit VCC (Grove pin3). Grove pin1/pin2 (UART) pass straight through J1 -> J2. LTE_EN: HIGH = ON. R1 pulls it LOW when the GPIO is Hi-Z (deep sleep, reset).

J1 IN (from Shield UART Grove port)

pin1 yellow=SIG1, pin2 white=SIG2, pin3 red=3V3, pin4 black=GND

pin1 = LTE_EN. pin2/pin3 left open on purpose (do not feed 5V) pin1/pin2 pass-through from J1, pin3 = switched VLTE

(QOD disabled by default) 0603 pads for experiments C2: CT slew-rate cap 1nF default, 0603 pads

R1: ON-pin pull-down. Required (ON must not float)

Test points (not assembled): V3V3_IN / VLTE / LTE_EN / GND

Grove IN / OUT / CTRL load-switch board (TPS22918DBVR)
Issue #88
Sheet: /
File: lte-power-switch.kicad_sch
Title: LTE power switch

Size: A4 | Rev: A
KiCad E.D.A. 10.0.6 | Id: 1/1
