makeOurCity/parking-status-sensor/hardware/lte-power-switch/renders/print-1to1-top.pdf

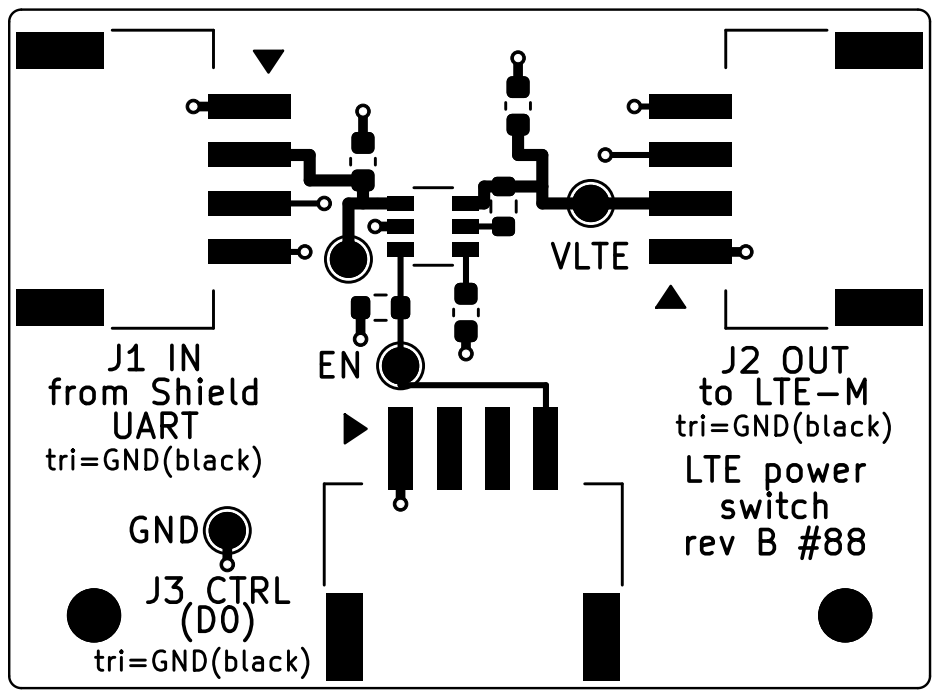
[picture p7: page 1]

tri=GND(black) J1 IN
from Shield UART
