makeOurCity/parking-status-sensor/hardware/lte-power-switch/lte-power-switch.kicad_pcb

## KiCad design hardware/lte-power-switch/lte-power-switch.kicad_pcb (2026-10-12)

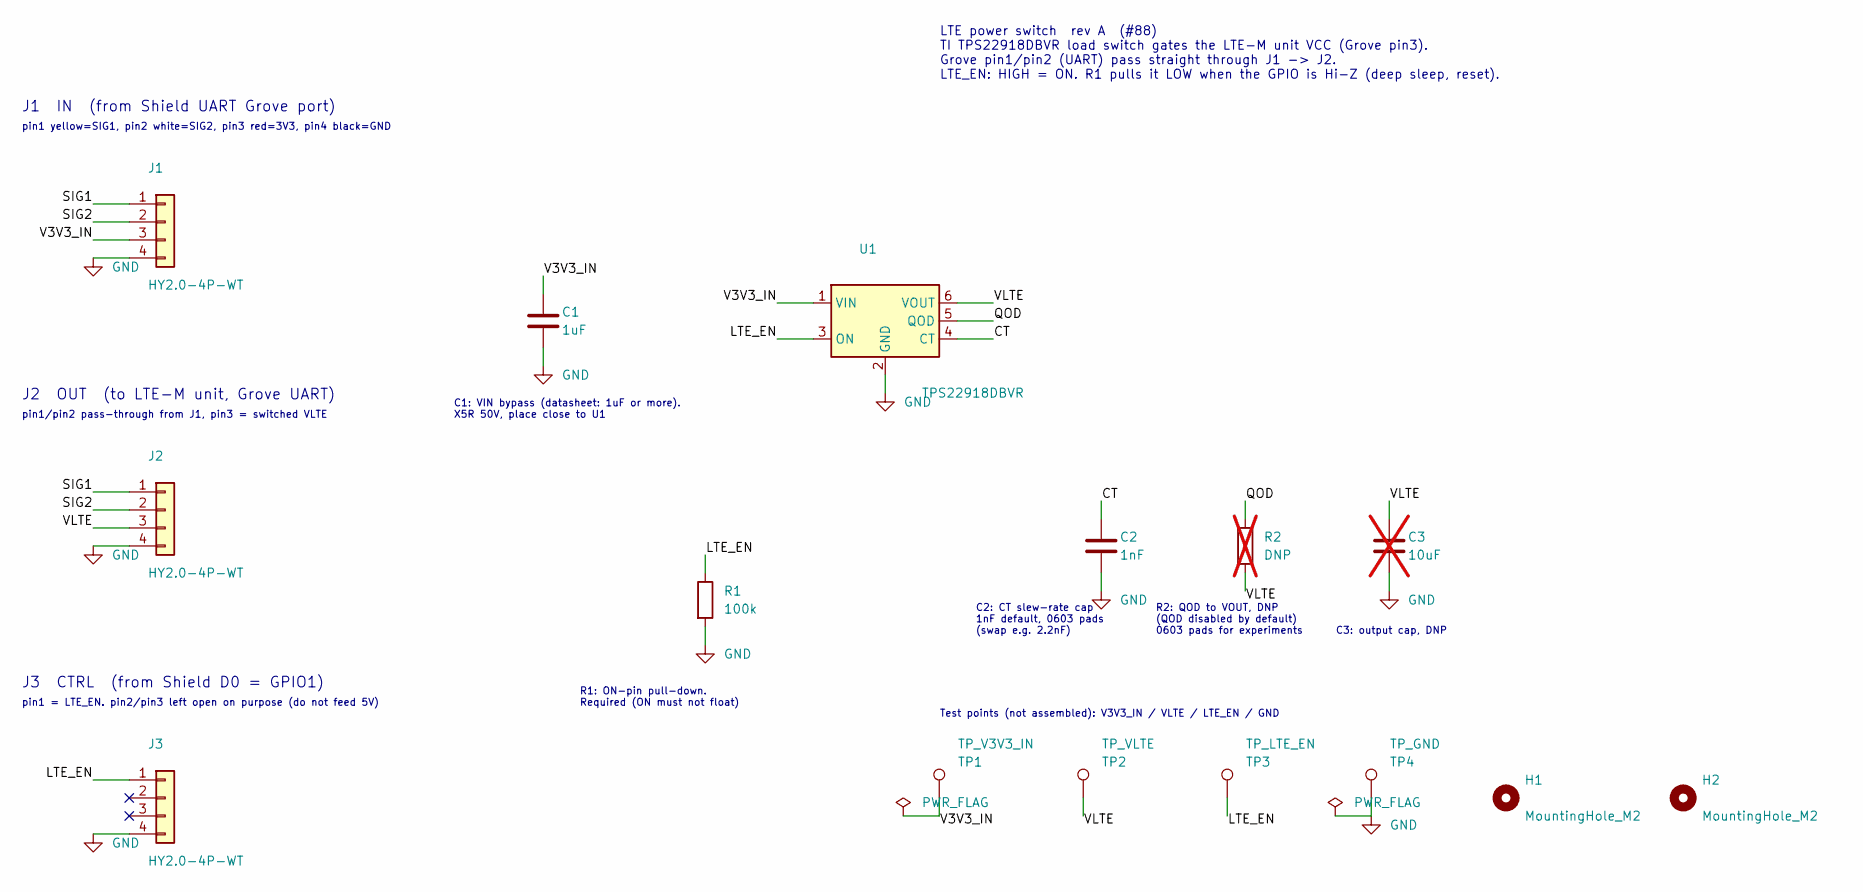
[picture p8: schematic lte-power-switch.kicad_sch, LTE power switch]

Parts:
C1: 1uF; C_0603_1608Metric; LCSC C15849
C2: 1nF; C_0603_1608Metric; LCSC C1588
C3: 10uF; C_0603_1608Metric; LCSC C19702; not fitted
H1, H2: MountingHole_M2; MountingHole_2.2mm_M2
J1, J2, J3: HY2.0-4P-WT; HY2.0-4P-WT_SMD-RA; LCSC C722729
R1: 100k; R_0603_1608Metric; LCSC C25803
R2: DNP; R_0603_1608Metric; not fitted
TP1: TP_V3V3_IN; TestPoint_Pad_D1.5mm
TP2: TP_VLTE; TestPoint_Pad_D1.5mm
TP3: TP_LTE_EN; TestPoint_Pad_D1.5mm
TP4: TP_GND; TestPoint_Pad_D1.5mm
U1: TPS22918DBVR; SOT-23-6_TPS22918DBVR; LCSC C131941

Connections:
/CT: C2.1, U1.4 (CT)
/LTE_EN: J3.1, R1.1, TP3.1, U1.3 (ON)
/QOD: R2.1, U1.5 (QOD)
/SIG1: J1.1, J2.1
/SIG2: J1.2, J2.2
/V3V3_IN: C1.1, J1.3, TP1.1, U1.1 (VIN)
/VLTE: C3.1, J2.3, R2.2, TP2.1, U1.6 (VOUT)
GND: C1.2, C2.2, C3.2, J1.4, J2.4, J3.4, R1.2, TP4.1, U1.2 (GND)

Notes on the sheet:
pin1 yellow=SIG1, pin2 white=SIG2, pin3 red=3V3, pin4 black=GND
J3 CTRL (from Shield D0 = GPIO1)
C1: VIN bypass (datasheet: 1uF or more). X5R 50V, place close to U1
J1 IN (from Shield UART Grove port)
C3: output cap, DNP
pin1 = LTE_EN. pin2/pin3 left open on purpose (do not feed 5V)
pin1/pin2 pass-through from J1, pin3 = switched VLTE
Test points (not assembled): V3V3_IN / VLTE / LTE_EN / GND
LTE power switch rev A (#88) TI TPS22918DBVR load switch gates the LTE-M unit VCC (Grove pin3). Grove pin1/pin2 (UART) pass straight through J1 -> J2. LTE_EN: HIGH = ON. R1 pulls it LOW when the GPIO is Hi-Z (deep sleep, reset).
C2: CT slew-rate cap 1nF default, 0603 pads (swap e.g. 2.2nF)
J2 OUT (to LTE-M unit, Grove UART)
R1: ON-pin pull-down. Required (ON must not float)
R2: QOD to VOUT, DNP (QOD disabled by default) 0603 pads for experiments

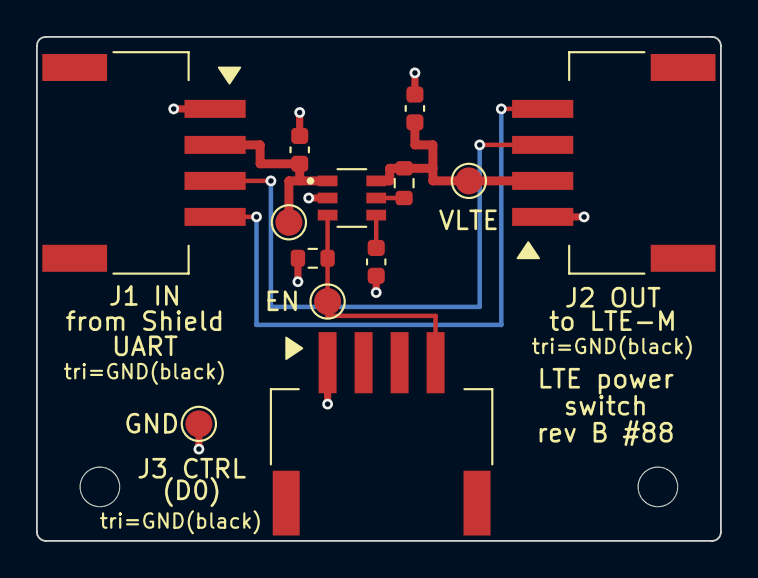
[picture p9: board lte-power-switch.kicad_pcb from above]

Board: 2 copper layers, 38.0 x 28.0 mm, 15 parts (0 on the bottom side), 8 nets.
