makeOurCity/parking-status-sensor/firmware/src/transport.cpp

#include "transport.h"

#define TINY_GSM_MODEM_SIM7080

#include <Arduino.h>
#include <MQTT.h>
#include <TinyGsmClient.h>
#include <WiFi.h>
#include <WiFiClientSecure.h>
#if PSS_MQTT_USE_TLS && !PSS_LTE_MODEM_TLS
#include <SSLClient.h>
#endif
#if PSS_LTE_MODEM_TLS
#include "lte_modem_tls.h"
#endif
#include <esp_system.h>
#include <string.h>
#include <sys/time.h>
#include <time.h>

#include "board.h"
#include "config.h"
#include "device_id.h"
#include "lorawan_payload.h"
#include "wio_e5.h"

RTC_DATA_ATTR static bool ltePlanDReady = false;
static bool lteUartStarted = false;
// #40: この起動でプロビジョニング（JP920 等）に成功したか。成功するまで Join・送信
// しない（工場出荷時の EU868 のまま電波を出さないため）。Deep Sleep をまたいで保持し、
// タイマー以外の起動では resetLoRaWanCache() で戻す。
RTC_DATA_ATTR static bool loRaWanProvisioned = false;
static bool loRaWanJoined = false;
static WioE5Result loRaWanLastResult = WioE5Result::kOk;

namespace {

WiFiClient wifiClient;
WiFiClientSecure wifiSecureClient;
MQTTClient wifiMqtt(1024);

TinyGsm modem(Serial1);
TinyGsmClient lteClient(modem);
#if PSS_LTE_MODEM_TLS
AwsLteSecureClient lteSecureClient(modem);
#elif PSS_MQTT_USE_TLS
SSLClient lteSecureClient(&lteClient);
#endif
MQTTClient lteMqtt(1024);

MQTTClient* activeMqtt = nullptr;
TransportKind activeTransport = TransportKind::kNone;

#if PSS_MQTT_USE_TLS
extern const char awsRootCa[] asm("_binary_certs_AmazonRootCA1_pem_start");
extern const char deviceCert[] asm("_binary_certs_device_pem_crt_start");
extern const char privateKey[] asm("_binary_certs_private_pem_key_start");
#endif

bool hasText(const char* value) {
  return value != nullptr && value[0] != '\0';
}

bool ensureLteClock();

Client& wifiNetworkClient() {
#if PSS_MQTT_USE_TLS
  return wifiSecureClient;
#else
  return wifiClient;
#endif
}

Client& lteNetworkClient() {
#if PSS_LTE_MODEM_TLS || PSS_MQTT_USE_TLS
  return lteSecureClient;
#else
  return lteClient;
#endif
}

void resetMqttSession(MQTTClient& mqtt, Client& net) {
  mqtt.disconnect();
  net.stop();
}

void resetWifiMqttLink() {
  resetMqttSession(wifiMqtt, wifiNetworkClient());
}

void resetLteMqttLink() {
  resetMqttSession(lteMqtt, lteNetworkClient());
}

void configureWifiTlsClient() {
#if PSS_MQTT_USE_TLS
  resetWifiMqttLink();
  wifiSecureClient.setCACert(awsRootCa);
  wifiSecureClient.setCertificate(deviceCert);
  wifiSecureClient.setPrivateKey(privateKey);
  wifiSecureClient.setHandshakeTimeout(30);
  wifiSecureClient.setTimeout(config::kMqttConnectTimeoutMs / 1000);
#endif
}

#if PSS_LTE_MODEM_TLS
void configureLteTlsClient() {
  resetLteMqttLink();
  lteSecureClient.setCaCert(lteModemCaCertName());
  lteSecureClient.setMtlsClientCert(lteModemClientCertName());
  lteSecureClient.setCertificate(lteModemCaCertName());
}

bool ensureLteModemCertificates() {
  if (!ensureLteClock()) {
    Serial.println("WARN: modem clock unavailable before TLS cert upload");
  }
  if (provisionLteModemCertificates(modem)) {
    return true;
  }
  clearLteModemCertificateCache();
  return false;
}
#elif PSS_MQTT_USE_TLS
void configureLteTlsClient() {
  resetLteMqttLink();
  lteSecureClient.setCACert(awsRootCa);
  lteSecureClient.setCertificate(deviceCert);
  lteSecureClient.setPrivateKey(privateKey);
  lteSecureClient.setTimeout(config::kMqttConnectTimeoutMs);
  lteSecureClient.setHandshakeTimeout(60);
}
#endif

String mqttClientId() {
  // AWS IoT policy allows iot:Connect only for client/${iot:Connection.Thing.ThingName}.
  if (config::kMqttUseTls) {
    return String(getDeviceId());
  }
  return String(getDeviceId()) + "-" +
         String(static_cast<uint32_t>(esp_random()), HEX);
}

void logModemAt(const char* cmd, uint32_t timeoutMs = 5000) {
  Serial.printf("AT%s\n", cmd);
  modem.sendAT(cmd);
  String response;
  modem.waitResponse(timeoutMs, response);
  if (response.length() > 0) {
    Serial.println(response);
  }
}

void logLteDiagnostics() {
  Serial.println("--- LTE diagnostics ---");
  logModemAt("+CPIN?");
  logModemAt("+CEREG?");
  logModemAt("+CREG?");
  logModemAt("+CMNB?");
  logModemAt("+CBANDCFG?");
  logModemAt("+CPSI?");
}

// #87: 接続の制限時間（hard deadline）。hardEndMs は絶対 millis（kNoLimit = 無期限）。
// 各 AT の待ちと delay を、残り時間で縮める。modem.init() は途中で止められないので、
// 残りが kInitReserveMs 未満なら呼ばない。
constexpr uint32_t kInitReserveMs = 20000;  // modem.init() 実用最悪約14s + 余裕
constexpr uint32_t kRetryMinMs = kInitReserveMs + 5000;  // stop 2s + settle 2.5s
constexpr uint32_t kDiagMinMs = 20000;                   // 診断 AT 4本
constexpr uint32_t kMinNetworkWaitMs = 5000;  // 実測 attach 約2.5s の約2倍

enum class LteInitResult : uint8_t { kOk, kSilent, kFailed, kDeadline };

uint32_t remainingMs(uint32_t endMs) { return remainingMsAt(endMs, millis()); }

uint32_t clampMs(uint32_t ms, uint32_t endMs) {
  const uint32_t r = remainingMs(endMs);
  return ms < r ? ms : r;
}

void delayBounded(uint32_t ms, uint32_t endMs) {
  const uint32_t d = clampMs(ms, endMs);
  if (d > 0) {
    delay(d);
  }
}

// OK でも ERROR でも「生きている」。waitResponse は無応答のとき 0 を返す。
bool modemAnyResponse(uint32_t timeoutMs) {
  modem.sendAT("");
  return modem.waitResponse(timeoutMs) != 0;
}

// 1回の取りこぼしで無応答と断定しない（1000ms x 2）。hard では縮めない（最大 +2s）。
bool modemIsSilent() {
  return !modemAnyResponse(1000) && !modemAnyResponse(1000);
}

// 各 AT の待ちを hard で縮める。期限に達したら false（打ち切り）。
// 期限内に最後まで進めば、現行どおり true を返す。
bool prepareLteForPlanD(uint32_t hardEndMs) {
  Serial.println("configure plan-D (Docomo Cat-M1)...");
  auto waitOk = [&](uint32_t ms) -> int8_t {
    return modem.waitResponse(clampMs(ms, hardEndMs));
  };
  auto expired = [&]() { return remainingMs(hardEndMs) == 0; };

  modem.sendAT("+CFUN=0");
  waitOk(10000L);
  if (expired()) return false;

  modem.sendAT("+CBANDCFG=\"CAT-M\",1,19");
  if (waitOk(10000L) != 1) {
    Serial.println("WARN: CBANDCFG 1,19 failed");
  }
  if (expired()) return false;
  logModemAt("+CBANDCFG?", clampMs(5000, hardEndMs));

  modem.sendAT(String("+CGDCONT=1,\"IP\",\"") + config::kLteApn + "\"");
  waitOk(10000L);
  if (expired()) return false;
  modem.sendAT(String("+CNCFG=0,1,\"") + config::kLteApn + "\"");
  waitOk(10000L);
  if (expired()) return false;

  modem.sendAT("+CMNB=1");
  if (waitOk(10000L) != 1) {
    Serial.println("WARN: CMNB=1 failed, trying CMNB=3");
    modem.sendAT("+CMNB=3");
    waitOk(10000L);
  }
  if (expired()) return false;
  modem.sendAT("+CNMP=38");
  waitOk(10000L);
  modem.sendAT("+CEREG=1");
  waitOk(1000L);
  modem.sendAT("+COPS=0");
  waitOk(10000L);
  if (expired()) return false;

  modem.sendAT("+CFUN=1");
  waitOk(15000L);
  delayBounded(3000, hardEndMs);
  if (expired()) return false;

  logModemAt("+CMNB?", clampMs(5000, hardEndMs));
  return true;
}

void startLteUart() {
  if (lteUartStarted) {
    Serial1.end();
    delay(50);
  }
  Serial1.begin(LTE_UART_BAUD, SERIAL_8N1, LTE_UART_RX, LTE_UART_TX);
  lteUartStarted = true;
}

void stopLteUart() {
  if (!lteUartStarted) {
    return;
  }
  Serial1.flush();
  Serial1.end();
  lteUartStarted = false;
}

bool wakeLteModemAt(uint32_t hardEndMs) {
  for (uint8_t i = 0; i < 10; ++i) {
    if (remainingMs(hardEndMs) < 1000) {
      return false;  // 1回分（waitResponse 1s）に満たなければ打ち切り
    }
    modem.sendAT("");
    if (modem.waitResponse(1000L) == 1) {
      return true;
    }
    delayBounded(300, hardEndMs);
  }
  return false;
}

void logLteInitFailure() {
  Serial.println("--- LTE init failure diagnostics ---");
  logModemAt("+CFUN?");
  logModemAt("+CPIN?");
  logModemAt("+CEREG?");
  logModemAt("+CNACT?");
}

bool recoverLteModemFromPowerOff(uint32_t hardEndMs) {
  Serial.println("LTE: recovering modem (AT wake + CFUN=1,1)...");
  if (!wakeLteModemAt(hardEndMs)) {
    Serial.println("LTE: no AT during wake");
    return false;
  }
  const uint32_t cfunMs = clampMs(30000L, hardEndMs);
  if (cfunMs == 0) {
    return false;
  }
  modem.sendAT("+CFUN=1,1");
  if (modem.waitResponse(cfunMs) != 1) {
    Serial.println("LTE: CFUN=1,1 failed");
    return false;
  }
  delayBounded(3000, hardEndMs);
  return wakeLteModemAt(hardEndMs);
}

bool sendModemAtOk(const char* cmd, uint32_t timeoutMs = 10000) {
  modem.sendAT(cmd);
  return modem.waitResponse(timeoutMs) == 1;
}

bool detachLteBearer() {
  bool ok = true;
  modem.sendAT("+CNACT=0,0");
  if (modem.waitResponse(15000L) != 1) {
    Serial.println("WARN: CNACT=0,0 failed or unsupported");
    ok = false;
  }
  modem.gprsDisconnect();
  modem.sendAT("+CGATT=0");
  if (modem.waitResponse(15000L) != 1) {
    Serial.println("WARN: CGATT=0 failed");
    ok = false;
  }
  delay(200);
  return ok;
}

bool modemRespondsToAt(uint32_t timeoutMs) {
  modem.sendAT("");
  return modem.waitResponse(timeoutMs) == 1;
}

bool requestModemPowerOff(uint8_t attempts) {
  for (uint8_t i = 0; i < attempts; ++i) {
    modem.sendAT("+CPOWD=1");
    if (modem.waitResponse(15000L, GF("NORMAL POWER DOWN")) == 1) {
      return true;
    }
    delay(500);
  }
  return false;
}

// hardEndMs: 絶対 millis（kNoLimit = 無期限）。failFastWhenSilent: 無応答と判定したら
// 再試行せず諦める（#87。リレー／ロードスイッチで電源を入切する機体。電源を入れても
// 約28s 応答しないのは故障とみなす）。
// failFastWhenSilent に関係なく、無応答が確定して返すときは UART を止める
// （無応答モデムへの AT+CPOWD 約33.5s を省く。powerOffLteModem は UART 未開始なら即 return）。
LteInitResult beginLteUartAndModem(uint32_t hardEndMs, bool failFastWhenSilent) {
  constexpr uint8_t kMaxAttempts = 3;
  bool lastAttemptSilent = false;
  bool deadlineHit = false;

  // 諦めるとき: 無応答なら UART を止めて kSilent、応答があれば ifAlive
  // （UART は開いたまま。後段の CPOWD に任せる）。
  auto abandon = [&](LteInitResult ifAlive) -> LteInitResult {
    ltePlanDReady = false;
    if (modemIsSilent()) {
      stopLteUart();
      return LteInitResult::kSilent;
    }
    return ifAlive;
  };

  for (uint8_t attempt = 1; attempt <= kMaxAttempts; ++attempt) {
    lastAttemptSilent = false;

    if (attempt > 1) {
      if (remainingMs(hardEndMs) < kRetryMinMs) {
        Serial.println("LTE modem init: deadline, no more retries");
        deadlineHit = true;
        break;
      }
      Serial.printf("LTE modem init retry %u/%u\n", attempt, kMaxAttempts);
      stopLteUart();
      delayBounded(2000, hardEndMs);
    }

    startLteUart();
    if (attempt == 1 && config::kLtePowerRelayEnabled) {
      // #46: このサイクルの relayLteOn() で今まさにコールド電源投入された直後。
      // 以下の "After CPOWD" 値は AT+CPOWD からの復帰用でコールドブートには
      // 短すぎるため、専用の待ち時間を使う。
      delayBounded(config::kLteColdBootSettleMs, hardEndMs);
    } else {
      // After CPOWD the modem needs Toff-on >= 2 s before UART is reliable.
      delayBounded(attempt == 1 ? 1500 : 2500, hardEndMs);
    }
    (void)wakeLteModemAt(hardEndMs);

    // modem.init() は中断できない（無応答 約10.3s、応答ありの実用最悪 約14s）。
    // 残りが kInitReserveMs 未満なら呼ばない。
    const bool canInit = remainingMs(hardEndMs) >= kInitReserveMs;

    if (canInit && modem.init()) {
      if (!ltePlanDReady) {
        Serial.println("LTE plan-D setup (first boot this power cycle)");
        if (!prepareLteForPlanD(hardEndMs)) {
          // 現行: logLteInitFailure(); continue;（recover は呼ばない）を維持。
          if (remainingMs(hardEndMs) >= kDiagMinMs) {
            logLteInitFailure();
          }
          if (remainingMs(hardEndMs) == 0) {
            // deadline で打ち切られた。init 成功直後なので通常は生きているが、
            // 途中で落ちた場合だけ CPOWD を省くため確認する。
            return abandon(LteInitResult::kDeadline);
          }
          continue;
        }
        ltePlanDReady = true;
      }
      return LteInitResult::kOk;
    }

    if (canInit) {
      Serial.printf("LTE modem.init() failed (attempt %u/%u)\n", attempt,
                    kMaxAttempts);
    } else {
      Serial.println("LTE modem.init() skipped: deadline");
      deadlineHit = true;
    }

    const bool silent = modemIsSilent();
    lastAttemptSilent = silent;
    if (silent && failFastWhenSilent) {
      Serial.println("LTE modem silent: giving up");
      stopLteUart();
      ltePlanDReady = false;
      return LteInitResult::kSilent;
    }
    if (!canInit) {
      break;
    }

    if (!silent && remainingMs(hardEndMs) >= kDiagMinMs) {
      logLteInitFailure();  // 無応答だと出力が空で約20s 無駄なので応答があるときだけ
    }
    if (attempt < kMaxAttempts && recoverLteModemFromPowerOff(hardEndMs)) {
      lastAttemptSilent = false;  // 復旧した。次の attempt で判定し直す
      continue;
    }
  }

  ltePlanDReady = false;
  if (lastAttemptSilent) {
    stopLteUart();
    return LteInitResult::kSilent;
  }
  return deadlineHit ? LteInitResult::kDeadline : LteInitResult::kFailed;
}

bool connectMqtt(MQTTClient& mqtt, Client& net, TransportMetrics& metrics) {
  mqtt.begin(config::kMqttHost, config::kMqttPort, net);
  mqtt.setOptions(60, true, 10000);

  const String clientId = mqttClientId();
  metrics.tcpTlsConnectMs = 0;
  metrics.mqttHandshakeMs = 0;

  const uint32_t tlsStart = millis();
  bool tcpOk = false;
  while ((millis() - tlsStart) < config::kMqttConnectTimeoutMs) {
    if (net.connect(config::kMqttHost, config::kMqttPort) > 0) {
      tcpOk = true;
      break;
    }
    delay(500);
  }
  metrics.tcpTlsConnectMs = millis() - tlsStart;
  if (!tcpOk) {
    metrics.mqttConnectMs = metrics.tcpTlsConnectMs;
    Serial.printf("MQTT TCP/TLS connect failed after %lu ms\n",
                  static_cast<unsigned long>(metrics.tcpTlsConnectMs));
    return false;
  }

  const uint32_t mqttStart = millis();
  constexpr uint32_t kMqttHandshakeBudgetMs = 15000;
  while ((millis() - mqttStart) < kMqttHandshakeBudgetMs) {
    const uint32_t attemptStart = millis();
    const bool connected =
        hasText(config::kMqttUsername)
            ? mqtt.connect(clientId.c_str(), config::kMqttUsername,
                           config::kMqttPassword, true)
            : mqtt.connect(clientId.c_str(), nullptr, nullptr, true);
    const uint32_t attemptMs = millis() - attemptStart;
    if (connected) {
      metrics.mqttHandshakeMs = millis() - mqttStart;
      metrics.mqttConnectMs = metrics.tcpTlsConnectMs + metrics.mqttHandshakeMs;
      Serial.printf(
          "MQTT connected (tcpTls=%lu mqtt=%lu total=%lu ms)\n",
          static_cast<unsigned long>(metrics.tcpTlsConnectMs),
          static_cast<unsigned long>(metrics.mqttHandshakeMs),
          static_cast<unsigned long>(metrics.mqttConnectMs));
      return true;
    }
    metrics.mqttHandshakeMs = attemptMs;
    delay(500);
  }

  metrics.mqttHandshakeMs = millis() - mqttStart;
  metrics.mqttConnectMs = metrics.tcpTlsConnectMs + metrics.mqttHandshakeMs;
  Serial.printf(
      "MQTT connect failed host=%s port=%u tls=%s clientId=%s tcpTls=%lu "
      "mqtt=%lu err=%d\n",
      config::kMqttHost, config::kMqttPort, config::kMqttUseTls ? "yes" : "no",
      clientId.c_str(), static_cast<unsigned long>(metrics.tcpTlsConnectMs),
      static_cast<unsigned long>(metrics.mqttHandshakeMs), mqtt.lastError());
  resetMqttSession(mqtt, net);
  return false;
}

bool connectWifi(TransportMetrics& metrics) {
  if (!hasText(config::kWifiSsid)) {
    return false;
  }

  Serial.printf("Wi-Fi connecting ssid=%s\n", config::kWifiSsid);
  WiFi.persistent(false);
  WiFi.mode(WIFI_STA);
  WiFi.setSleep(false);
  WiFi.begin(config::kWifiSsid, config::kWifiPassword);

  const uint32_t start = millis();
  while (WiFi.status() != WL_CONNECTED &&
         (millis() - start) < config::kWifiConnectTimeoutMs) {
    delay(250);
    Serial.print(".");
  }
  Serial.println();

  metrics.networkConnectMs = millis() - start;
  if (WiFi.status() != WL_CONNECTED) {
    Serial.println("Wi-Fi connect failed");
    WiFi.disconnect(true);
    WiFi.mode(WIFI_OFF);
    return false;
  }

  metrics.transport = TransportKind::kWifi;
  metrics.wifiRssi = WiFi.RSSI();
  Serial.printf("Wi-Fi connected ip=%s rssi=%ld mqtt_tls=%s\n",
                WiFi.localIP().toString().c_str(),
                static_cast<long>(metrics.wifiRssi),
                config::kMqttUseTls ? "yes" : "no");

  if (config::kMqttUseTls) {
    syncClock(config::kTimeSyncTimeoutMs);
  }

  configureWifiTlsClient();
  if (!connectMqtt(wifiMqtt, wifiNetworkClient(), metrics)) {
    resetWifiMqttLink();
    WiFi.disconnect(true);
    WiFi.mode(WIFI_OFF);
    return false;
  }

  activeMqtt = &wifiMqtt;
  activeTransport = TransportKind::kWifi;
  return true;
}

// Convert a UTC calendar date to Unix epoch without relying on TZ/mktime
// (Howard Hinnant's days_from_civil algorithm).
time_t epochFromUtc(int y, int mo, int d, int h, int mi, int s) {
  y -= mo <= 2;
  const long era = (y >= 0 ? y : y - 399) / 400;
  const unsigned yoe = static_cast<unsigned>(y - era * 400);
  const unsigned doy = (153 * (mo + (mo > 2 ? -3 : 9)) + 2) / 5 + d - 1;
  const unsigned doe = yoe * 365 + yoe / 4 - yoe / 100 + doy;
  const long days = era * 146097 + static_cast<long>(doe) - 719468;
  return static_cast<time_t>(days) * 86400 + static_cast<time_t>(h) * 3600 +
         mi * 60 + s;
}

// Read the modem's network-provided clock (AT+CCLK, populated via NITZ) and set
// the ESP32 system time. Unlike lwIP SNTP (configTime), this works over LTE
// because it never leaves the modem's AT interface.
bool setSystemClockFromModem() {
  int y = 0, mo = 0, d = 0, h = 0, mi = 0, s = 0;
  float tzHours = 0;
  if (!modem.getNetworkTime(&y, &mo, &d, &h, &mi, &s, &tzHours)) {
    return false;
  }
  // Reject modem power-on defaults (e.g. 1980/2004/2080) so we don't set a
  // bogus clock when NITZ has not been delivered yet.
  if (y < 2024 || y > 2035) {
    Serial.printf("modem clock not from network yet (year=%d)\n", y);
    return false;
  }

  const time_t utc =
      epochFromUtc(y, mo, d, h, mi, s) - static_cast<time_t>(tzHours * 3600.0f);
  if (utc < 1700000000) {
    return false;
  }

  timeval tv{};
  tv.tv_sec = utc;
  settimeofday(&tv, nullptr);
  Serial.printf("clock set from modem utc=%ld tz=%.2f\n",
                static_cast<long>(utc), tzHours);
  return true;
}

// Ensure the system clock is valid on the LTE path. Prefers the (free) NITZ
// clock; falls back to the modem's own NTP (+CNTP) over the data bearer.
bool ensureLteClock() {
  if (time(nullptr) > 1700000000) {
    return true;
  }
  if (setSystemClockFromModem()) {
    return true;
  }
  Serial.println("NITZ unavailable; trying modem NTP (+CNTP)");
  modem.NTPServerSync(String(config::kNtpServer), 0);
  return setSystemClockFromModem();
}

bool connectLte(TransportMetrics& metrics, uint32_t hardEndMs) {
  if (!config::kLteEnabled) {
    return false;
  }

  if (config::kLteOnly) {
    WiFi.mode(WIFI_OFF);
  }

  Serial.println("LTE-M connecting");
  const uint32_t start = millis();

  // #87: 電源を入れる機体（リレー／ロードスイッチ）は、無応答のモデムを再試行せず諦める。
  const LteInitResult init =
      beginLteUartAndModem(hardEndMs, config::kLtePowerRelayEnabled);
  if (init != LteInitResult::kOk) {
    metrics.modemSilent = (init == LteInitResult::kSilent);
    Serial.println("LTE modem init failed");
    return false;
  }

  // #87: hard deadline。残りが kMinNetworkWaitMs 未満なら待たずに失敗にする。
  const uint32_t netRemaining = remainingMs(hardEndMs);
  if (netRemaining < kMinNetworkWaitMs) {
    Serial.println("LTE network wait skipped: deadline");
    (void)powerOffLteModem();
    return false;
  }
  const uint32_t netTimeoutMs = config::kLteNetworkTimeoutMs < netRemaining
                                    ? config::kLteNetworkTimeoutMs
                                    : netRemaining;
  if (!modem.waitForNetwork(netTimeoutMs)) {
    Serial.println("LTE network failed");
    logLteDiagnostics();
    (void)powerOffLteModem();
    return false;
  }

  if (remainingMs(hardEndMs) == 0) {
    Serial.println("LTE data attach skipped: deadline");
    (void)powerOffLteModem();
    return false;
  }
  if (!modem.gprsConnect(config::kLteApn, config::kLteUser,
                         config::kLtePassword)) {
    Serial.println("LTE data attach failed");
    (void)powerOffLteModem();
    return false;
  }

  metrics.transport = TransportKind::kLte;
  metrics.networkConnectMs = millis() - start;
  Serial.printf("LTE-M connected operator=%s csq=%d\n",
                modem.getOperator().c_str(), modem.getSignalQuality());

  if (config::kMqttUseTls) {
    if (remainingMs(hardEndMs) == 0) {
      Serial.println("LTE TLS setup skipped: deadline");
      (void)powerOffLteModem();
      return false;
    }
#if PSS_LTE_MODEM_TLS
    if (!ensureLteModemCertificates()) {
      Serial.println("LTE modem TLS cert setup failed");
      (void)powerOffLteModem();
      return false;
    }
    configureLteTlsClient();
#elif PSS_MQTT_USE_TLS
    if (!ensureLteClock()) {
      Serial.println("WARN: modem clock unavailable before TLS; continuing");
    }
    configureLteTlsClient();
#endif
  }

  if (remainingMs(hardEndMs) == 0) {
    Serial.println("MQTT connect skipped: deadline");
    resetLteMqttLink();
    (void)powerOffLteModem();
    return false;
  }
  if (!connectMqtt(lteMqtt, lteNetworkClient(), metrics)) {
    resetLteMqttLink();
    (void)powerOffLteModem();
    return false;
  }

  activeMqtt = &lteMqtt;
  activeTransport = TransportKind::kLte;
  return true;
}

void beginLoRaWanUart() {
  if (!wioE5Started()) {
    wioE5Begin(Serial1, LORAWAN_UART_RX, LORAWAN_UART_TX, LORAWAN_UART_BAUD);
  }
}

// 送信するサイクルで毎回 AT+JOIN を送る。Join 済みなら Wio-E5 は無線を使わずに
// "Joined already" を返す（約 85ms）ので、Join 状態を ESP32 側に持たない。
bool connectLoRaWan(TransportMetrics& metrics) {
  beginLoRaWanUart();
  const uint32_t start = millis();
  if (!loRaWanProvisioned) {
    loRaWanProvisioned = wioE5ProvisionOtaa(config::kLoRaWanAppEui,
                                            config::kLoRaWanAppKey, kLoRaWanCoreFPort);
    if (!loRaWanProvisioned) {
      Serial.println("LoRaWAN provisioning failed; not joining");
      loRaWanLastResult = WioE5Result::kError;
      loRaWanJoined = false;
      return false;
    }
  }

  WioE5JoinInfo join{};
  loRaWanLastResult = wioE5Join(config::kLoRaWanJoinTimeoutMs, &join);
  loRaWanJoined = loRaWanLastResult == WioE5Result::kOk;
  metrics.networkConnectMs = millis() - start;
  metrics.loraAlreadyJoined = join.alreadyJoined;
  if (!loRaWanJoined) {
    return false;
  }
  metrics.transport = TransportKind::kLoRaWan;
  activeTransport = TransportKind::kLoRaWan;
  return true;
}

bool reconnectTransport(TransportMetrics& metrics, uint32_t hardEndMs) {
  if (activeTransport == TransportKind::kLoRaWan) {
    return connectLoRaWan(metrics);
  }

  if (activeTransport == TransportKind::kWifi &&
      WiFi.status() == WL_CONNECTED && activeMqtt == &wifiMqtt) {
    if (activeMqtt->connected()) {
      return true;
    }
    Serial.println("MQTT reconnect (Wi-Fi still up)");
    configureWifiTlsClient();
    return connectMqtt(wifiMqtt, wifiNetworkClient(), metrics);
  }

  if (activeTransport == TransportKind::kLte && activeMqtt == &lteMqtt) {
    if (activeMqtt->connected()) {
      return true;
    }
    if (!modem.isGprsConnected()) {
      disconnectTransport();
      return connectTransport(metrics, hardEndMs);
    }
    Serial.println("MQTT reconnect (LTE still up)");
#if PSS_MQTT_USE_TLS
    if (config::kMqttUseTls) {
      configureLteTlsClient();
    }
#endif
    return connectMqtt(lteMqtt, lteNetworkClient(), metrics);
  }

  disconnectTransport();
  return connectTransport(metrics, hardEndMs);
}

}  // namespace

void resetLteRadioCache() {
  ltePlanDReady = false;
}

void resetLoRaWanCache() {
  loRaWanProvisioned = false;
}

bool connectTransport(TransportMetrics& metrics, uint32_t hardEndMs) {
  const uint8_t savedAttempts = metrics.transportAttempts;
  metrics = TransportMetrics{};
  metrics.transportAttempts = savedAttempts;
  activeMqtt = nullptr;
  activeTransport = TransportKind::kNone;

  // #40: LoRaWAN env は LoRaWAN のみ（README §4.3 の LoRaWAN > LTE > Wi-Fi の
  // フォールバックは将来。LTE とは Grove UART を共有するため同時には有効にできない）。
  if (config::kLoRaWanEnabled) {
    return connectLoRaWan(metrics);
  }

  const bool wifiConfigured = hasText(config::kWifiSsid);
  if (!config::kLteOnly && wifiConfigured && connectWifi(metrics)) {
    return true;
  }

  if (wifiConfigured && config::kLteEnabled && !config::kLteOnly) {
    metrics.usedFallback = true;
    Serial.println("Wi-Fi failed; falling back to LTE-M");
  }

  return connectLte(metrics, hardEndMs);
}

bool connectTransportWithRetry(TransportMetrics& metrics, uint32_t cycleStartMs,
                               uint32_t budgetMs) {
  metrics = TransportMetrics{};
  metrics.transportAttempts = 0;

  // #87: soft（budgetMs）は新しい試行を始めるかの判断だけに使う。実行中の AT 待ちと
  // waitForNetwork は hard で縮める。
  // hard = soft + 10s（ただし kCycleMaxActiveMs を超えない。config::kConnectHardMs と同じ式）。
  const uint32_t hardBudgetMs = (budgetMs + 10000 < config::kCycleMaxActiveMs)
                                    ? budgetMs + 10000
                                    : config::kCycleMaxActiveMs;
  const uint32_t hardEndMs = deadlineAfter(cycleStartMs, hardBudgetMs);

  for (uint8_t attempt = 1; attempt <= config::kTransportMaxAttempts; ++attempt) {
    if ((millis() - cycleStartMs) >= budgetMs) {
      Serial.println("transport retry budget exhausted (connect phase)");
      break;
    }

    if (attempt > 1) {
      disconnectTransport();
      delay(config::kRetryDelayMs);
    }

    metrics.transportAttempts = attempt;
    Serial.printf("transport attempt %u/%u\n", attempt,
                  config::kTransportMaxAttempts);

    if (connectTransport(metrics, hardEndMs)) {
      metrics.transportAttempts = attempt;
      return true;
    }

    // #87: モデムが AT に一度も応答しない（電源が来ていない疑い）。再試行しても回復しない
    // ので、次の attempt（disconnectTransport + delay + 再接続）に進まず諦める。
    if (metrics.modemSilent) {
      Serial.println("LTE modem silent; skipping transport retry");
      break;
    }
  }

  return false;
}

bool reconnectActiveTransport(TransportMetrics& metrics, uint32_t hardEndMs) {
  return reconnectTransport(metrics, hardEndMs);
}

bool probeLteModem(LteProbeResult& result) {
  result = LteProbeResult{};
  const uint32_t start = millis();

  Serial.println("=== LTE-M probe ===");
  Serial.printf("uart rx=%d tx=%d baud=%d\n", LTE_UART_RX, LTE_UART_TX,
                LTE_UART_BAUD);

  result.uartOk = true;

  Serial.println("[1/5] modem init (AT) + plan-D setup...");
  // test 系 env: 従来どおり（無期限、3 回リトライ、診断あり）。
  result.initOk =
      beginLteUartAndModem(kNoLimit, false) == LteInitResult::kOk;
  if (!result.initOk) {
    Serial.println(
        "FAIL: modem init (AT/CLTS/SIM/plan-D). If after CPOWD test, power-cycle "
        "LTE module or wait for retry.");
    result.elapsedMs = millis() - start;
    return false;
  }
  Serial.println("OK");

  strncpy(result.modemInfo, modem.getModemInfo().c_str(),
          sizeof(result.modemInfo) - 1);
  strncpy(result.imei, modem.getIMEI().c_str(), sizeof(result.imei) - 1);
  result.signalQuality = modem.getSignalQuality();

  Serial.printf("modem=%s\n", result.modemInfo);
  Serial.printf("imei=%s\n", result.imei);
  Serial.printf("csq=%d (0-31 valid, 99=unknown)\n", result.signalQuality);

  Serial.println("[2/5] SIM check...");
  logModemAt("+CPIN?");

  Serial.println("[3/5] network registration (plan-D Cat-M1)...");
  result.networkOk =
      modem.waitForNetwork(config::kLteNetworkTimeoutMs);
  if (!result.networkOk) {
    Serial.println("FAIL: not registered (check SIM, antenna, Cat-M1 coverage)");
    logLteDiagnostics();
    strncpy(result.operatorName, modem.getOperator().c_str(),
            sizeof(result.operatorName) - 1);
    Serial.printf("operator=%s\n", result.operatorName);
    result.elapsedMs = millis() - start;
    return false;
  }
  strncpy(result.operatorName, modem.getOperator().c_str(),
          sizeof(result.operatorName) - 1);
  Serial.printf("OK operator=%s\n", result.operatorName);

  Serial.printf("[4/5] data attach apn=%s user=%s...\n", config::kLteApn,
                config::kLteUser);
  result.gprsOk = modem.gprsConnect(config::kLteApn, config::kLteUser,
                                    config::kLtePassword);
  if (!result.gprsOk) {
    Serial.println("FAIL: GPRS attach failed (check APN / SIM plan)");
    result.elapsedMs = millis() - start;
    return false;
  }
  Serial.println("OK");

  result.signalQuality = modem.getSignalQuality();
  Serial.printf("[5/5] done csq=%d elapsed_ms=%lu\n", result.signalQuality,
                static_cast<unsigned long>(millis() - start));
  result.elapsedMs = millis() - start;
  activeTransport = TransportKind::kLte;
  return true;
}

void printLteProbeResult(const LteProbeResult& result) {
  Serial.println("--- LTE probe summary ---");
  Serial.printf("uart=%s init=%s network=%s gprs=%s\n",
                result.uartOk ? "ok" : "ng", result.initOk ? "ok" : "ng",
                result.networkOk ? "ok" : "ng", result.gprsOk ? "ok" : "ng");
  Serial.printf("modem=%s imei=%s operator=%s csq=%d elapsed_ms=%lu\n",
                result.modemInfo, result.imei, result.operatorName,
                result.signalQuality,
                static_cast<unsigned long>(result.elapsedMs));
  Serial.println(result.initOk && result.networkOk && result.gprsOk
                     ? "RESULT: PASS"
                     : "RESULT: FAIL");
}

bool syncClock(uint32_t timeoutMs) {
  time_t now = time(nullptr);
  if (now > 1700000000) {
    return true;
  }

  // lwIP SNTP (configTime) only reaches the network via the Wi-Fi netif. On the
  // LTE path the modem clock is set separately (ensureLteClock), so skip here to
  // avoid a guaranteed timeout that would burn the whole budget for nothing.
  if (WiFi.status() != WL_CONNECTED) {
    return false;
  }

  configTime(0, 0, config::kNtpServer);

  const uint32_t start = millis();
  while ((millis() - start) < timeoutMs) {
    time_t now = time(nullptr);
    if (now > 1700000000) {
      Serial.println("Time synchronized");
      return true;
    }
    delay(250);
  }

  Serial.println("Time sync timed out");
  return false;
}

bool publishTelemetryConfirmed(const char* payload, TransportMetrics& metrics) {
  if (activeMqtt == nullptr || !activeMqtt->connected()) {
    Serial.println("MQTT is not connected");
    return false;
  }

  const char* topic = getMqttTopic();
  const size_t len = strlen(payload);
  const uint32_t start = millis();

  // 256dpi/MQTT: QoS>0 publish blocks until PUBACK or timeout.
  activeMqtt->setTimeout(config::kMqttPublishTimeoutMs);
  const bool confirmed =
      activeMqtt->publish(topic, payload, len, false, config::kMqttQos);

  metrics.publishMs = millis() - start;
  Serial.printf(
      "MQTT publish topic=%s confirmed=%s qos=%u bytes=%u ms=%lu err=%d\n",
      topic, confirmed ? "yes" : "no", config::kMqttQos,
      static_cast<unsigned>(len), static_cast<unsigned long>(metrics.publishMs),
      activeMqtt->lastError());
  return confirmed;
}

bool publishUplinkConfirmed(const uint8_t* data, size_t len, TransportMetrics& metrics) {
  if (activeTransport != TransportKind::kLoRaWan || !loRaWanJoined) {
    Serial.println("LoRaWAN is not joined");
    return false;
  }
  char hex[kLoRaWanCorePayloadSize * 2 + 1];
  if (len > kLoRaWanCorePayloadSize) {
    Serial.printf("LoRaWAN payload too long: %u\n", static_cast<unsigned>(len));
    return false;
  }
  loRaWanToHex(data, len, hex, sizeof(hex));

  WioE5UplinkInfo info{};
  loRaWanLastResult =
      wioE5SendConfirmedHex(hex, config::kLoRaWanUplinkTimeoutMs, &info);
  if (loRaWanLastResult == WioE5Result::kNotJoined) {
    loRaWanJoined = false;  // 次の試行の reconnectActiveTransport() で Join し直す
  }
  metrics.publishMs = info.elapsedMs;
  metrics.hasLoRaRx = info.hasRx;
  metrics.loraRssi = info.rssi;
  metrics.loraSnr = info.snr;
  return loRaWanLastResult == WioE5Result::kOk;
}

int activeMqttState() {
  if (activeTransport == TransportKind::kLoRaWan) {
    return loRaWanJoined ? 0 : -2;  // ブートモードの「接続を使い回すか」の判定用
  }
  if (activeMqtt == nullptr) {
    return -1;
  }
  return activeMqtt->connected() ? 0 : -2;
}

int activeMqttLastError() {
  if (config::kLoRaWanEnabled) {
    // #40: sync ledger の prevMqttError に入れる。-100 - WioE5Result（ok は 0）。
    return loRaWanLastResult == WioE5Result::kOk
               ? 0
               : -100 - static_cast<int>(loRaWanLastResult);
  }
  if (activeMqtt == nullptr) {
    return 0;
  }
  return activeMqtt->lastError();
}

TransportKind activeTransportKind() {
  return activeTransport;
}

bool powerOffLteModem(LtePoweroffResult* detail) {
  const uint32_t start = millis();
  LtePoweroffResult local{};
  LtePoweroffResult& r = detail != nullptr ? *detail : local;

  lteMqtt.disconnect();
  resetLteMqttLink();

  if (!lteUartStarted) {
    Serial.println("powerOffLteModem: skip (UART not started)");
    activeMqtt = nullptr;
    activeTransport = TransportKind::kNone;
    r.elapsedMs = millis() - start;
    return false;
  }

  // #76: 以前はここで detachLteBearer()（CNACT=0,0 / CGATT=0）を送っていたが、
  // CGATT=0 はネットワークからの切り離しを待つため 15s のタイムアウトまで応答が
  // なく（AT マニュアル上の最大応答時間は 75s）、しかも AT+CPOWD=1 自身が
  // 電源断の前に同じ切り離しを行うので、約 15s を二重に待っていた。
  // SIM7080G HW Design §3.2.2 が挙げる正式な電源断（AT+CPOWD=1）だけにする。
  Serial.println("powerOffLteModem: AT+CPOWD=1");
  r.cpowdAccepted = requestModemPowerOff(2);

  // SIM7080 HW Design Table 9: Toff(uart) >= 1.8 s after power-off issue.
  delay(2000);

  // 電源が切れていれば応答はないので、確認は短い時間で打ち切る（#76）。
  r.modemSilent = !modemRespondsToAt(500);
  Serial.printf("powerOffLteModem: cpowd=%s modemSilent=%s\n",
                r.cpowdAccepted ? "yes" : "no",
                r.modemSilent ? "yes" : "no");

  if (r.cpowdAccepted && !r.modemSilent) {
    Serial.println(
        "powerOffLteModem: CPOWD accepted but modem still responds; "
        "trying CFUN=0 fallback");
    if (sendModemAtOk("+CFUN=0", 15000)) {
      r.radioOffFallback = true;
      delay(500);
      r.modemSilent = !modemRespondsToAt(3000);
      Serial.printf("powerOffLteModem: after CFUN=0 modemSilent=%s\n",
                    r.modemSilent ? "yes" : "no");
    }
  }

  stopLteUart();
  activeMqtt = nullptr;
  activeTransport = TransportKind::kNone;
  r.elapsedMs = millis() - start;
  return r.cpowdAccepted && r.modemSilent;
}

bool radioOffLteModem() {
  lteMqtt.disconnect();
  resetLteMqttLink();

  if (!lteUartStarted) {
    startLteUart();
    delay(1000);
    if (!modem.testAT()) {
      Serial.println("radioOffLteModem: no AT response");
      return false;
    }
  }

  (void)detachLteBearer();
  const bool ok = sendModemAtOk("+CFUN=0", 15000);
  delay(500);
  Serial.printf("radioOffLteModem: CFUN=0 => %s\n", ok ? "ok" : "fail");
  stopLteUart();
  activeMqtt = nullptr;
  activeTransport = TransportKind::kNone;
  return ok;
}

bool probeLteModemAt(uint32_t timeoutMs) {
  if (!lteUartStarted) {
    startLteUart();
    delay(500);
  }
  const bool ok = modemRespondsToAt(timeoutMs);
  Serial.printf("probeLteModemAt => %s\n", ok ? "RESPONSE" : "silent");
  return ok;
}

void disconnectTransport() {
  wifiMqtt.disconnect();

  if (config::kLoRaWanEnabled) {
    // #40: 送信しなかったサイクルでも毎回 Wio-E5 を AT+LOWPOWER で寝かせる。
    // Deep Sleep 復帰時の ROM ログ（GPIO43 = Wio-E5 RX）などで起こされたまま
    // 次のサイクルまで待機電流が増えるのを防ぐ（docs/40-lorawan-design.md §6）。
    beginLoRaWanUart();
    const bool slept = wioE5Wake(3) && wioE5Sleep();
    if (!slept) {
      Serial.println("LoRaWAN: Wio-E5 did not enter LOWPOWER");
    }
    wioE5End();
    activeTransport = TransportKind::kNone;
    return;
  }

  if (activeTransport == TransportKind::kWifi) {
    wifiClient.stop();
    wifiSecureClient.stop();
    WiFi.disconnect(true);
    WiFi.mode(WIFI_OFF);
    lteMqtt.disconnect();
    activeMqtt = nullptr;
    activeTransport = TransportKind::kNone;
  } else if (config::kLteKeepModem && activeTransport == TransportKind::kLte) {
    Serial.println("disconnectTransport: PSS_LTE_KEEP_MODEM — skip poweroff");
    lteMqtt.disconnect();
    resetLteMqttLink();
    modem.gprsDisconnect();
    activeMqtt = nullptr;
    activeTransport = TransportKind::kNone;
  } else if (lteUartStarted || activeTransport == TransportKind::kLte) {
    LtePoweroffResult detail{};
    const bool ok = powerOffLteModem(&detail);
    Serial.printf(
        "lte poweroff: cpowd=%s silent=%s radioOff=%s ok=%s (%lu ms)\n",
        detail.cpowdAccepted ? "yes" : "no",
        detail.modemSilent ? "yes" : "no",
        detail.radioOffFallback ? "yes" : "no", ok ? "yes" : "no",
        static_cast<unsigned long>(detail.elapsedMs));
  } else {
    lteMqtt.disconnect();
    activeMqtt = nullptr;
    activeTransport = TransportKind::kNone;
  }
}

const char* transportName(TransportKind transport) {
  switch (transport) {
    case TransportKind::kWifi:
      return "wifi";
    case TransportKind::kLte:
      return "lte";
    case TransportKind::kLoRaWan:
      return "lorawan";
    case TransportKind::kNone:
    default:
      return "none";
  }
}
