makeOurCity/parking-status-sensor/firmware/include/lorawan_payload.h

#pragma once

#include <stddef.h>
#include <stdint.h>

#include <array>

#include "classify.h"
#include "sensor.h"
#include "sync_ledger.h"

// #40: LoRaWAN アップリンクのペイロード（fPort 1, ver 1, 固定 18 バイト）。
// バイト配置は docs/40-lorawan-design.md §3。デコーダは tools/lorawan/decode.py。
// deviceId / timestamp は載せない（クラウド側で Wireless Device 名と受信時刻から補う）。

// RP002 AS923 の DR2 の最大アプリペイロード（UplinkDwellTime=0）。AWS IoT Core for
// LoRaWAN（AS923-1）は TxParamSetupReq で dwell time を OFF に指定してくる（実機で確認、
// docs/40-lorawan-design.md §3）。dwell が有効なネットワークでは DR2 の上限は 11 バイトで、
// その場合 DR2 の送信は Wio-E5 が "Length error" で拒否する。
constexpr size_t kAs923Dr2MaxPayload = 51;
constexpr size_t kLoRaWanCorePayloadSize = 18;
static_assert(kLoRaWanCorePayloadSize <= kAs923Dr2MaxPayload,
              "core uplink must fit AS923 DR2 (dwell time off)");

constexpr uint8_t kLoRaWanCoreFPort = 1;
constexpr uint8_t kLoRaWanCoreVersion = 1;

enum class SendReason : uint8_t {
  kStateChange = 0,
  kHeartbeat = 1,
  kPendingRetry = 2,
  kBootMode = 3,
};

struct LoRaWanUplinkInput {
  ParkingStatus status = ParkingStatus::kUnknown;
  SendReason reason = SendReason::kStateChange;
  bool coldBoot = false;  // esp_reset_reason() == ESP_RST_POWERON
  RawSample raw{};
  CycleOutcome prevOutcome = CycleOutcome::kNone;
  uint8_t prevAttempts = 0;   // 3 で頭打ち
  uint8_t bootSlot = 0;       // 0 = 通常サイクル、1-7 = ブートモードの何回目か
  uint32_t prevActiveMs = 0;  // 250ms 単位、255（63.75s）で頭打ち
  int threshold = 0;          // 判定閾値（ポテンショメーター有効時は算出値）。0-65535 に収める
  uint32_t bootCount = 0;     // RTC の bootCount（LTE-M 版 JSON の power.bootCount と同じ）
  uint8_t resetReasonCode = 0;  // LoRaWanResetReason（4bit）
  uint8_t wakeCauseCode = 0;    // LoRaWanWakeCause（4bit）
};

// power.resetReason / power.wakeCause の文字列（main.cpp の resetReasonToString /
// wakeCauseToString）と同じ並び。デコーダ（tools/lorawan/decode.py）も同じ表を持つ。
enum class LoRaWanResetReason : uint8_t {
  kOther = 0,
  kPowerOn,
  kBrownout,
  kDeepSleep,
  kSoftware,
  kPanic,
  kTaskWdt,
  kIntWdt,
  kWdt,
};

enum class LoRaWanWakeCause : uint8_t {
  kOther = 0,
  kTimer,
  kPowerOn,
};

using LoRaWanCorePayload = std::array<uint8_t, kLoRaWanCorePayloadSize>;

LoRaWanCorePayload encodeLoRaWanCore(const LoRaWanUplinkInput& in);

// payload を大文字 16 進文字列にする（AT+CMSGHEX 用）。out は 2*len+1 以上。
void loRaWanToHex(const uint8_t* data, size_t len, char* out, size_t outSize);
