makeOurCity/parking-status-sensor/(commit log)

2026-06-17 docs: add hardware design doc and update README for BOM/battery/LTE-M decisions
    Issue #1 の検討結果をまとめたドキュメントを追加し、READMEを更新。
    - docs/hardware.md を新規作成: 確定BOM・センサ選定理由・バッテリー選定理由・LTE-M選定理由・物理部品仕様を記載
    - README: 電源をモバイルバッテリー→LiPoに変更、通信をLTE-M本命・Wi-Fiサブに変更、BOM・消費電流・稼働日数テーブルを更新
2026-06-17 docs: align README with current LiPo-first design decisions
    Remove stale mobile-battery PoC verification, update repo metadata,
    PoC duration, and appendix structure to match the actual repository.
2026-06-17 docs: add GitHub Flow guidance for AI agents and Cursor
    Declare Issue-driven GitHub Flow in AGENTS.md and a always-on Cursor rule.
2026-06-17 docs: add detailed BOM, schematic, and wiring for issue #11
    Wi-Fi 第1弾の試作1台向けに詳細BOM・回路図・組み立て手順を追加し、
    hardware.md と README から相互リンクする。
2026-06-17 docs: AWS IoT Core + Lambda 構成を README 等に反映
    PoC 第1弾は Wi-Fi + AWS IoT Core + Lambda ブリッジとし、
    LTE-M/SORACOM は将来フェーズと明記する（Issue #4 結論と整合）。
2026-06-17 docs: 現場棚卸しの暫定記録とドキュメント運用ルールを追加
    Issue #2 の候補一覧とチェック状況を共有し、調査メモの更新・PR頻度の方針を AGENTS.md に明文化する。
2026-06-21 docs: DevKit/XIAO 二段階開発方針をドキュメントに反映
    開発ベンチ（ESP32 DevKit）と PoC 実証機（XIAO）の役割分担と
    PlatformIO マルチ環境方針を README・hardware.md・firmware/README に記載。
2026-06-21 feat(firmware): PlatformIO 雛形と DevKit ベンチ実装（Issue #5 第1段階）
    TCS34725 読み取り・RGB LED 色ミラー・devkit/xiao-s3 マルチ環境を追加。
    DevKit 配線は firmware/devkit-bench.md に記載。
2026-06-22 docs: Grove接続・積層固定・Shield電源の設計方針を反映
    センサ固定を透明テープ＋黒シート積層に変更し、配線をGrove統一、
    LiPo接続先をGrove Shield BATパッドに、LTE-M型番を確定記載する。
2026-07-01 docs: Grove I2C Color Sensor V3.0（VEML6040）採用を反映
    試作機・DevKit ベンチとも Grove 統一接続とし、TCS34725 基板＋L字コネクタ＋ピン入替の旧構成を廃止。ファームは VEML6040 ドライバ移行が必要な旨を明記。
2026-07-01 docs: XIAO 一本化とロードマップ Issue #22 を反映
    DevKit をアーカイブ扱いにし、README §10・firmware README・platformio デフォルト環境を xiao-s3 に更新。
2026-07-01 feat(firmware): VEML6040 センサ読み取りを実装（Closes #5）
    TCS34725/DevKit コードを削除し、sensor モジュールで R/G/B/W を
    シリアル出力する。モジュール構成と通信経路方針をドキュメント化。
2026-07-03 fix(firmware): VEML6040 初期化と実機確認向けの改善
    XIAO の I2C ピン指定を維持するようプローブ方式に変更し、失敗時に I2C スキャンを出力する。
    積分時間 320 ms に合わせサンプル間隔を 400 ms に調整し、devkit-bench をアーカイブ注記に更新。
2026-07-06 feat(infra): AWS IoT Core プロビジョニングと Lambda スタブ（Closes #4）
    プライベート AWS で端末受信基盤を構築するため、IoT Core 設計ドキュメント、
    プロビジョニングスクリプト、CloudWatch ログのみの Lambda スタブを追加する。
    Orion 連携は #7 に委ね、CLI 疎通（IoT Core → Lambda）までを本 PR の範囲とする。
2026-07-06 docs: AWS 管理者向け引き渡し手順を追加（Issue #27）
    組織クラウド環境構築を開発チームから切り離し、クラウド管理者が
    docs/aws-admin-handoff.md に沿って IoT Core と Orion Sandbox を
    セットアップできるようにする。
2026-07-06 feat(firmware): add AWS IoT TLS and LTE-M transport path
    Enable MQTT over TLS to AWS IoT Core with embedded device certs, Basic
    Ingest topic generation, and SIM7080G LTE-M support including SSLClient
    timeout fixes verified on real hardware.
2026-07-06 docs: record LTE-M overnight test and power interval rationale
    Document 75-cycle AWS IoT run, SORACOM cost, active timing phases,
    and README §6.2 updates for sleep interval vs receive interval.
2026-07-07 feat(firmware): LTE modem TLS and clock sync for #31/#30
    Move AWS TLS to SIM7080, sync time via modem CCLK/CNTP instead of lwIP
    SNTP on LTE-only builds, and keep network metrics on outbox replay. Add
    power-measurement docs with before/after active timings (~68s to ~6s).
2026-07-07 docs: record #31 design decisions and disconnect timing notes
    Document Beam/Grove deferrals, LoRa as a parallel track, and why
    disconnect/poweroff is measured via U200-1A rather than firmware metrics.
2026-07-07 docs: split LTE investigation from power measurement (#31)
    Move LTE active analysis to lte-active-investigation.md and slim
    power-measurement.md to U200-1A scope. Rename branch for LTE PR.
2026-07-10 docs: record #31 power measurement and add U200 DevKit logger
    U200-1A mAh measurement (pattern D) shows ~2.1 mAh/cycle and ~22 mA
    sleep baseline; update README §6.2 and add tools/power-logger for DevKit.
    Closes #31
2026-07-10 docs: add #25 low-power investigation memo (WIP)
    Phase 0 前提の事前調査記録。未取得資料に基づく断定の撤回と証拠ルールを明記する。
2026-07-10 docs(#25): Phase 0 完了 — Grove LTE 待機電流とソフト電源断の結論
    U200 抜き差しで待機 ≈23 mA の内訳を確定し、強化 CPOWD 追試まで含めて
    Grove U128 上ではソフト電源断が電池運用の解にならないと記録する。
    25-low-power-mode.md を設計の正として起票し、計測ログ・一次資料を同梱。
2026-07-10 docs: mustPublish 実装を Issue #39 に参照
2026-08-24 fix(#41): タスクウォッチドッグを追加しLTE接続ハングを検知
    現場実証で接続フェーズがハングし約40分間publishが停止した事象を受け、
    xiao-s3-aws-lte にesp_task_wdtを導入。サイクル開始時のみリセットする
    ことで、接続/publishフェーズ内部でハングした場合にリブートするように
    した。resetReasonToString()にwatchdog起因のリセット種別も追加。
2026-08-25 fix(#43): VEML6040 の積分時間を320ms→40ms(最小)に変更
2026-08-25 fix(#43): 積分時間40ms化に合わせStatusThresholdを暫定スケールダウン(100→13)
2026-09-15 docs(#25): Phase 2 — 現地電池切れ分析とラッチングリレーによるハード電源遮断設計
    現地試験で待機≈22mA前提の7日試算に反し10時間強で電池切れが発生した件を
    CloudWatchテレメトリから分析し、電圧sagトリップ仮説と、Grove 2-Coil
    Latching RelayによるLTE-Mモジュールのみのハード電源遮断案をまとめる。
    ロガー部品未着のため今回はリレーのみ投入する判断も記録。
2026-09-17 feat(#46): Grove 2-Coil Latching Relay で LTE-M の電源を物理遮断
    Grove Shield のポートVCCはソフトのみで遮断できない(Phase 0で確定済みの制約)
    ため、ラッチングリレー経由でLTE-Mモジュールの5V線を物理的にON/OFFする。
    - relay.h/relay.cpp新規: initRelay()(起動時安全RESET)/relayLteOn()/relayLteOff()
    - mustPublish()を実装: 状態変化 or pendingValid or heartbeat(既定12サイクル=1時間)
    でのみ送信し、変化なしサイクルはリレーに触れずLTE-Mを一切通電しない
    - sleepNow()で無条件にrelayLteOff()を呼び、どの復帰経路でも二重にフェイルセーフ
    - リレー投入直後のコ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
2026-09-19 docs(#47): 状態変化履歴ログ(NVSリングバッファ)の設計を確定
    サブエージェントによる4回のレビューサイクルでNVS容量計算を確定した後、
    ユーザー確認により記録方針を「状態変化時のみ」から「毎サイクル無条件」
    に変更し、raw値(MQTTペイロードのraw相当)を含む形で再設計した。
2026-09-19 feat(#47): 毎サイクルのセンサー観測をNVSリングバッファに記録
    USB接続時に現地で状態変化履歴をシリアルから確認できるようにする。
    docs/47-history-log-design.md の設計(v5)通り、状態変化検知ではなく
    毎サイクル無条件でtimestamp+status+raw(red/green/blue/white)を
    16バイトエントリとしてNVS(namespace pss_hlog)のセグメント分割リング
    バッファに記録する。
    - 新規 history_log.h/.cpp: SyncLedger/送信フローとは完全に独立
    (transport.h/relay.h/sync_ledger.hを一切includeしない。nmで確認済み)
    - main.cpp: classifyStatus()直後に1回、mustPublish()より前でフック
    -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
2026-09-19 fix(#47): nvs statsログをダンプ末尾に移動、実機検証結果を反映
    実機検証(xiao-s3-aws-lte-relay-debug)で判明した制約に対応する:
    ESP32-S3のネイティブUSB CDCは、ホストがリセット後に再接続した直後の
    数行のSerial.print出力を確実に取りこぼす(pio device monitor/自前の
    pyserialスクリプト/log2fileフィルタの3方式すべてで再現)。
    initHistoryLog()内で起動直後に出していたnvs_get_stats()の結果を
    historyLogDumpToSerial()の末尾(ダンプ本体を出し終えた後)に移動し、
    確実に出力されるようにした。
    実機で得られた実測値:
    hlog: nvs stats used=72 free=558 total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
2026-09-19 feat(#50): 電源投入直後のブートモード(無条件送信+短間隔連続送信)を実装 (#51)
    現地調整時、電源投入直後にmustPublish()の変化検知/heartbeat判定を待たず
    最大1時間送信されない問題を解消するため、コールドブート(ESP_RST_POWERON)
    検知時のみ0,1,2,3,4分の計5回・1分間隔で無条件送信するブートモードを追加。
    - LTE/MQTT接続はブートモード中(最大約4分)切断せず維持し、3段階の接続
    再利用方式(フル接続/維持/MQTTのみ再接続+フォールバック)で要件を満たす
    - transport.hにactiveTransportKind()を新設し、接続再利用時もペイロードの
    n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
2026-09-19 docs(#52): よく使う開発コマンドをまとめたSkillを追加
    firmware書込/監視・ローカルMosquitto検証・AWS IoT Core/Lambda操作・
    SORACOM SIM運用・消費電力ロガー計測のコマンドがREADME/docs各所に
    散在しており都度探す手間があったため、Claude Code Skillとして
    .claude/skills/dev-commands/SKILL.md にまとめた。
    Closes #52
2026-09-19 feat(#54): iPad満空表示灯シミュレーターアプリを追加
    実表示灯にアクセスできない開発環境でも満/空の発光を模擬確認できるよう、
    SwiftUI/iPadOS製の16x16ドットマトリクスシミュレーターを tools/ 配下に追加。
    ドットパターンは実機写真から scripts/extract_pattern.py で機械的に抽出した。
2026-09-19 docs(#54): iPad満空表示灯シミュレーターのREADMEを追加
    power-logger/soracom と同じ形式で、ビルド・実機転送手順、操作方法、
    ドットパターンの再生成手順をまとめた。
2026-09-19 fix(#54): 満/空ドットパターンを目視確認して微修正
    インタラクティブな編集ツール(Artifact)で実機写真と見比べながら、
    満5件・空10件のドットON/OFFを手動補正した。
2026-09-19 feat(#54): アプリアイコンを追加
    App Store Connectへのアップロード時にCFBundleIconName未設定でバリデーション
    エラーとなったため、ドットマトリクスをモチーフにした1024x1024アイコンを追加。
2026-09-19 chore(#54): バージョン1.3(ビルド3)・輸出コンプライアンス自動応答を設定
    ITSAppUsesNonExemptEncryption=false をInfo.plistに設定し、以降の
    TestFlightアップロードで暗号化に関する質問が出ないようにした。
2026-09-19 docs(#57): 充電はDeep Sleepと無関係にハードウェアのみで継続することを追記
    Grove Shield上のETA6003チャージICはXIAOのGPIOと接続されておらず、
    USB-C給電時はESP32S3の動作状態に関わらず自律的に充電を継続する。
    USB-C接続検知によるDeep Sleep抑制の要否を調査した結果を反映。
2026-09-19 docs(#50): ブートモード関連ドキュメントを更新・実機検証結果を追記 (#59)
    - data-model.md: MQTT payloadの診断フィールドにbootMode.*を追加(Orion非マッピング対象として明記)
    - sync-delivery-design.md: mustPublish()節に#50のコールドブート例外を追記
    - firmware/README.md: 関連Issue表に#50を追加
    - 50-boot-mode-design.md: 実機(CloudWatch×電源ログ突き合わせ)での検証結果を追記
    - esptool書き込み後のリセットでもブートモードが発動した実例
    - 5回の送信・接続維持・所要時間が設計通りだったことの実測データ
    - heartbeatへの復帰が正常だったこと
    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
2026-09-20 docs(#60): 現地調整用ポテンショメーターによる判定閾値可変化の設計を確定
    Grove - Rotary Angle SensorをGrove Shield for XIAOのD1/A1(GPIO2)に接続し、
    対数マッピングで判定閾値PSS_STATUS_THRESHOLDを実行時に算出できるようにする設計。
    新規potentiometer.h/cppモジュール、PSS_POT_*ビルドフラグ、テレメトリJSONへの
    pot.*フィールド追加を含む。ピンはIssue本文のD2/GPIO3ではなくD1/GPIO2を採用
    (GPIO3はESP32-S3のストラッピングピンのため、起動安定性リスクを設計側で回避)。
2026-09-20 docs(#60): PotReadingの明示的コンストラクタを設計docに反映
    main.cppのBootModeSendInfoと同じ理由(デフォルトメンバ初期化子付き構造体は
    2引数の波括弧初期化に使えない)で気づいた実装レビュー観点をv3設計docに追記。
2026-09-20 feat(#60): 現地調整用ポテンショメーターで判定閾値を可変化
    対数マッピング(threshold = round(30 × (15000/30)^(adc/4095)))で
    PSS_STATUS_THRESHOLDを実行時に算出する。新規PSS_POT_ENABLED(既定0)で
    ゲートし、未配線の既存機体には一切影響しない。runCycle()/runBootMode()の
    両方で毎回読み直し、テレメトリJSONに実効閾値と生ADC値(pot.enabled/adcRaw)を
    追加する。設計: docs/60-potentiometer-threshold-design.md
    - board_xiao.h: POT_ADC_PIN(D1/GPIO2)を追加
    - config.h: PSS_POT_ENABLED/SAMPLE_COUNT/THRESHOLD_MIN/MAXを追加
    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
2026-09-20 docs(#60): 実機での消費電力実測結果と稼働日数の再試算を反映
    電源ロガー(tools/power-logger)での実測により、ポテンショメーターを常時接続
    したままだとDeep Sleep待機電流が0.45mA→0.75mAへ増加することが判明。
    PSS_CHANGE_ONLY_SEND/PSS_HEARTBEAT_CYCLES(実質1時間に1回送信)を反映して
    稼働日数を再試算した結果、定常運用で約19%(24日分)の低下という結論に至った。
    - 60-potentiometer-threshold-design.md: §10として実機検証結果(動作確認・
    消費電力実測・稼働日数再試算・ケーブル撤去時の運用手順)を追加。§2.6/§6に
    参照を追記
    - hardware.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
2026-09-20 feat(#60): ポット閾値をブートモード時のみ読み取りNVSへ永続化(v5)
    ユーザー提案により設計変更。従来はrunCycle()毎にADCを生読みしていたため、
    現地調整完了後にGroveケーブルを抜くとGPIO2がフローティングになり閾値が
    不定値でブレる問題があった。ADCの生読みをブートモード(#50)の5回の送信時
    だけに限定し、結果をNVS(Preferences、namespace pss_pot)へ永続化する設計に
    変更。通常サイクル(runCycle())はNVSの値を使うだけでADCには一切触れない。
    これによりブートモード完了後はいつでもケーブルを抜いてよくなり、v4で
    記載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
2026-09-20 docs(#60): v5実機検証結果・既知の起動安定性懸念を記録してマージ判断
    v5(NVS永続化)の実機検証結果を追加: ブートモード完了後につまみを回しても
    threshold/pot.adcRawが変化しないことを確認し、ケーブル抜去確認の意図を
    同等以上の方法で満たしたと判断(§8テスト項目8)。
    ユーザー判断により、屋外実地確認(§8テスト項目7)は本PRのスコープ外、
    物理的なケーブル抜去確認(テスト項目8)は追加実施不要と結論。
    一方、電源投入直後にLTE-M/センサーの接続が安定するまで複数回の電源
    再投入が必要になる事象が、別々の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
2026-09-20 docs(#60): USB-C充電時にシステム電源が瞬断しないことを実測で裏付け
    電源ロガー(tools/power-logger)の実測で、USB-C接続時に約65秒間-413.5mAの
    定電流充電(3903mV→4007mV、典型的なLiPoのCC充電プロファイル)が観測され、
    充電の開始・終了前後でDeep Sleep放電電流(0.44mA)に乱れなく復帰することを
    確認した。§2.7で述べていた「充電がブートモードの再発動=NVSの意図しない
    上書きを引き起こさない」という結論の裏付けとなる。
2026-09-20 docs(#60): §11(リレー空きチャンネル)を実装済み・動作確認済みに更新
    実機検証(§10.1)時点で、ポットのVCCは既にリレー空きチャンネル経由(§11想定の
    配線)で給電されていたことが後日判明。当初「将来の拡張案・本PRのスコープ外」
    として記録していたが、実際には既に実装済みであった。
    後続の電源ロガー実測を確認したところ、Deep Sleep中の待機電流は一貫して
    300〜450µA(ポットなし相当)に収まっており、リークが再現しないことを確認した。
    §10.2で報告した0.75mAの生ログは、その後pio device monitor > fileを再実行し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
2026-09-20 docs: バッテリー稼働日数の記述を2026-09時点の実測ベースに更新
    README.md §6.2の初期試算(2026-07時点、#46リレー実装前)は待機電流≈22mAが
    支配的な前提のままだった。#46リレー・PSS_CHANGE_ONLY_SEND実装後の実測
    (待機0.45mA)を反映した§6.2.5を新設し、5分間隔でも定常運用で約127日と
    大幅に改善していることを追記。#60ポットの消費電力影響(リレー空きチャンネル
    経由の給電で解消済み)にも言及。
    firmware/README.mdの2026-07実機セクションにも、待機電流の最新値への
    ポインタを追記。
    いずれも旧来の記述(2026-07時点の実測・試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
2026-09-20 docs(#63): 起動時リレー不安定の机上調査結果を#60設計docに反映
    Firmware書き込み直後にのみリレーが機械的に切り替わらない事象について、
    firmware/コード・PlatformIOの書き込み設定・リレーモジュールの公式回路図
    まで掘り下げた机上調査(#63)の結果を§6-#7・§10.1に追記する。
    有力仮説: esptool書き込み時のGPIO1 Hi-Z滞留 + リレーSIGピンの弱いプル
    ダウン(100kΩ)によるエッジ検出回路の誤発火。実用的な回避策(書き込み時は
    リレーのGroveケーブルを外す)と、外部裏付け調査の結果も記録する。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
2026-09-23 feat(#68): iOSログビューアアプリ向けCognito認証基盤を追加
    初回サインインのみでリフレッシュトークンが3650日有効なCognito User Pool
    + Identity Poolを構築し、CloudWatch Logs読み取り専用に限定したIAMロール
    を割り当てる。AWSアクセスキーを端末に持たせずに済む構成。
2026-09-23 feat(#68): CloudWatch Logsダッシュボードのiosアプリを追加
    Cognito認証（USER_PASSWORD_AUTH初回サインイン+リフレッシュトークン自動更新）
    とCloudWatch Logs Insightsクエリのみで構成し、外部AWS SDKには依存しない。
    SigV4署名は自前実装し、実際のAWSエンドポイントに対して動作確認済み。
    - ダッシュボード: デバイス別の現在Status・最終受信時刻・オフライン警告、直近5件のログ
    - デバイス詳細: 選択したデバイスの全ログ（直近14日・最大200件）
    - オフライン判定はハートビート(1時間)を踏まえて90分閾値
    Cognito App ClientをUSER_PASSWORD_A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
2026-09-23 feat(#68): ダッシュボード・詳細画面に色/閾値/JST時刻を表示
    生ログの1行表示だけでは実用にならないというフィードバックを受けて、
    ペイロードのJSONをクライアント側でパースし構造化して表示するよう変更。
    - ダッシュボードの直近ログ・デバイス詳細画面: 色スウォッチ・R/G/B/Clear・
    閾値・判定主体(determinedBy)を表示
    - 全時刻表示をJST（Asia/Tokyo）に統一
    - デバイス詳細画面は生ログを折りたたみ表示に変更し、デフォルトでは
    整理された情報のみを表示
    Simulatorで実際にサインインし、実データでダッシュボー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
2026-09-23 feat(#68): ダッシュボードのビジュアルデザインを刷新
    情報構成はそのまま、カード型レイアウト・配色・タイポグラフィを一新。
    - List/Formのデフォルトスタイルから、カード型のScrollViewベースの
    レイアウトに変更（Theme.swift でアクセントカラー・カードスタイルを一元管理）
    - ダッシュボード上部にデバイス数・稼働中・オフラインのサマリータイルを追加
    - Status/色/RGBC値をチップ・グロー付きカラースウォッチで表示
    - サインイン画面にアイコン・グラデーション背景を追加
    あわせて、再読込（pull-to-refresh）中に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
2026-09-23 feat(#68): 生ログをエントリタップで展開・整形表示に変更
    「生ログを表示」の独立した行をやめ、エントリ（カード）自体をタップすると
    生ログが展開されるように変更。ダッシュボードの直近ログ・デバイス詳細画面
    両方に適用。展開の可否はシェブロンアイコンの向きで示す。
    あわせて生ログの可読性を改善: JSON部分をインデント・キーをソートして
    整形表示し、Lambdaが付与するプレフィックス（タイムスタンプ・request ID）
    は控えめなスタイルで区切って表示するようにした（LogEntry.formattedRawLog）。
    standalone Sw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
2026-09-23 feat(#68): アプリアイコンを追加
    Theme.swiftのアクセントカラー(インディゴ)のグラデーション背景に、
    サインイン画面と同じ sensor.fill シンボルを白で配置。macOS上でAppKit/
    Core Graphicsを使い1024x1024のPNGをローカル生成し、単一サイズの
    AppIcon.appiconsetとして組み込んだ（Xcode 14+のuniversalアイコン形式）。
2026-09-23 feat(#68): アプリがアクティブな間・再オープン時に自動読み込み
    手動でのpull-to-refreshを極力減らすため、ダッシュボード・デバイス詳細
    画面の両方に自動リフレッシュを追加。
    - scenePhaseの変化を.task(id:)で監視し、アクティブになるたびに新しい
    ループを開始（バックグラウンド時は自動的に停止）
    - アクティブな間は30秒間隔で再読込を継続（AWSConfig.autoRefreshInterval）
    - アプリを再度開いたときも、フォアグラウンド復帰と同時に即座に再読込
    Simulatorでバックグラウンド→フォアグラウンド復帰時の即時リロード、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
2026-09-23 feat(#68): バックグラウンドでの定期更新と状態変化通知を追加
    BackgroundTasksフレームワーク(BGAppRefreshTask)でバックグラウンドでも
    定期的にCloudWatch Logsをチェックし、デバイスのStatus変化・オフライン化/
    復帰を検知したらローカル通知で知らせるようにした。
    - BackgroundRefreshScheduler: BGTaskSchedulerへの登録・スケジューリング・
    実行ハンドラ。バックグラウンド遷移時と実行完了時に次回分を再スケジュール
    - DeviceStateStore/DeviceStateDiff: 前回チェック時の状態をUserDefaultsに
    永続化し、ステータス変化・オフライン化・復帰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
2026-09-24 feat(#68): 稼働状況をダッシュボードのデバイスカードに表示
    デバイス詳細画面に稼働状況カード(ブートカウント・稼働時間)を置いたのは
    UIとして誤りだったため撤回し、ダッシュボードの各デバイスカードに表示する
    形に変更。デバイス詳細画面はログ一覧のみに戻した。
    - デバイス数が増えてもクエリ数が増えない設計: ステータス集計クエリに
    bootCountを追加し、「直近でbootCount=1だったタイムスタンプ」を
    deviceIdごとにstatsで一括取得する専用クエリを1本追加（計2クエリ、
    デバイス台数に関係なく一定）
    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
2026-09-24 fix(#68): デバイスカードを「デバイス自体のアイコン」として再構成
    上部に浮いていた車アイコンをやめ、ステータスカラーをタイル全体の枠・
    背景として使うことで、カード自体が1台のデバイスを表す「アイコン」に
    見えるようにした。中身（デバイス名・ステータスバッジ・受信何分前・
    ブート回数・稼働時間）はすべて中央揃えでタイル内に配置。オフライン
    警告は右上の小さなバッジに変更（アイコンアプリのバッジ表示に近い形）。
2026-09-24 fix(#68): デバイスカードを自前描画の基板シェイプに変更
    SF Symbolsのcpu.fillアイコンをそのまま拡大して切り抜く方式は、ピン部分の
    比率が大きすぎて情報表示エリアを圧迫していた（実機で確認）。実際に使って
    いるXIAO ESP32-S3モジュール（左右にキャスタレーションピンが並ぶ基板）を
    参考に、自前のCustom Shapeで「左右2辺だけにピンがある基板」を描画する
    方式に変更。
    - BoardBodyShape: 本体の角丸長方形（ピン分だけ左右をinset）
    - BoardPinsShape: 左右の辺に並ぶ小さなピン矩形（本体とは別Shapeにして
    個別にfillし、本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
2026-09-24 fix(#68): 基板シェイプのピンを輪郭の内側に収めて虫っぽさを解消
    ピンが本体の輪郭の外側に飛び出していたため、左右対称に脚が生えた虫の
    ように見えてしまっていた。輪郭は単純な角丸長方形のまま崩さず、ピンは
    その内側にごく短いマークとして描くように変更（外にはみ出す要素をなくす）。
2026-09-24 fix(#68): デバイスカードのキャステレーションをリアルに、全体の質感も向上
    - ピンを単色矩形から「金メッキパッド+輪郭上に切り欠いた丸穴」に変更
    （実際のSMDモジュールのキャステレーションビアの見た目）。Canvasで
    グラデーション塗り+destinationOutブレンドモードによる丸穴のくり抜きを
    実装。1辺あたり7個（実機のXIAO ESP32-S3を参考）
    - 本体の塗りを単色からステータスカラーの縦グラデーションに変更
    - ドロップシャドウを追加して浮遊感・立体感を出した
    - 枠線をステータスカラー+内側の薄いハイライト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
2026-09-24 fix(#68): USB-Cポート・アンテナコネクタ・チップ部品を追加
    実機のXIAO ESP32-S3の写真に寄せて、上辺にUSB-Cポート、左下にu.FL
    アンテナコネクタ、下辺に小さなチップ部品を追加（BoardAccents）。
    いずれもテキストが表示される中央エリアには重ならない、上下の薄い
    余白部分だけに収まるよう配置。
    空のスロット（3枠に満たない分の埋め合わせ）は、表示する実データが
    ないため、テキストが載る位置も含めて実物の見た目に寄せた完全な
    装飾表示に変更。中央にモジュール風のブロック（seeed studioの
    シルク印刷相当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
2026-09-25 feat(#68): 接続方式(LTE/Wi-Fi)表示とログ再読込時の状態保持を修正
    ## トランスポート種別の表示
    将来LoRaWANデバイスが追加された際に既存のLTE-Mデバイスと区別できる
    ようにするための準備として、telemetryの`network.transport`を
    デバイスカードに表示するようにした。
    - ダッシュボード集計クエリにtransportのparse+stats集計を追加
    （デバイス数に関わらずクエリ数は変わらない）
    - DeviceSummaryにtransportを追加し、"lte"→"LTE"等の表示ラベルに変換
    （未知の値は大文字化してそのまま表示するので、ファームウェアが
    "lora"を追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
2026-09-25 feat(#68): ログ一覧・詳細にリセット理由とブートカウントを表示
    生ログを1件ずつ開かないと、ブラウンアウト等の異常リセットがいつ発生した
    か分からなかったため、直近のログ・デバイス詳細ログの両方に各エントリの
    bootCount・resetReasonを表示するようにした。
    - PowerInfoにresetReasonLabel（フル表記）/shortResetReasonLabel（省略形）
    /isNotableRestart（deep_sleep以外かどうか）を追加
    - 直近のログ（コンパクト表示）: "#49 スリープ" のように省略形で表示
    - デバイス詳細（フル表示）: "ブート 49回" "ディープスリープ復帰" を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
2026-09-26 docs(#25): 8/25 現地試験の停止原因（極性逆接続による IC 焼損）を追記
    Phase 2 ドキュメントでは 8/25 の早期停止を消費電力・電池の問題として
    分析していたが、原因は LiPo の極性逆接続による電流制御 IC の焼損と
    確定したため、§1 冒頭に注記し §1.3 の仮説を棄却扱いにする。
2026-09-26 feat(#74): 電源ロガーに瞬間的な電圧低下を捉える高速モードを追加
    LTE-M 通電時などの ms 単位の電圧低下を、LiPo で動かす構成のまま
    計測できるよう、U200 (INA226) ロガーに高速モード (logger-devkit-fast)
    を追加する。
    - INA226 を変換 140us・平均なしに設定し、電圧はレジスタポインタを
    固定して読み取りトランザクション 1 回で連続取得 (約 0.46ms 間隔)。
    電流は 8 回に 1 回だけ読む
    - 50ms ごとに最低電圧・平均電圧・最大/最小/平均電流を出力する
    - OLED 更新は計測を止めるため、試験対象機の Deep Sleep 中に限る
    - 起床サイ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
2026-09-26 fix(#77): CloudWatch Logs Insights のスキャン量を削減
    400日分をスキャンするresetQuery（bootCount=1検索）が30秒ごとの自動
    更新のたびに実行されており、Logs Insightsのスキャン量のほとんどを
    占めていた。以下の3点で対応する。
    - fetchDeviceSummariesを、安価なfetchDeviceStatuses（状態・稼働
    状況の取得のみ）と高価なfetchResetTimestamps（400日分のリセット
    時刻取得）に分離
    - DashboardViewModelでfetchResetTimestampsの結果をキャッシュし、
    アプリ起動時・手動更新時・bootCountの減少検知時のみ再実行
    - 自動更新間隔を30秒から5分に延長（端末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
2026-09-26 docs(#74): LiPo 運用時の LTE-M 給電経路を確定し、5V 表記を訂正
    Grove Shield と U128 の回路図から、電池で動かしているときは 5V 系統が
    無効で、ESP32-S3 と LTE-M が Shield の ETA3410 の 3.3V 出力を共有して
    いることを確認した。hardware.md の「要確認」を確定内容に置き換え、
    #46 設計の「5V 線」が実際には 3.3V であることを追記する。
2026-09-27 fix(#76): LTE 切断時の明示的な bearer 切断をやめ、約 30 秒の空待ちをなくす
    powerOffLteModem() が AT+CPOWD=1 の前に detachLteBearer()
    （CNACT=0,0 / CGATT=0）を送っていた。CGATT=0 はネットワークからの
    切り離しを待つため 15s のタイムアウトまで応答がなく、続く CPOWD=1 も
    同じ切り離しを待たされて約 15s かかっていた（切断処理の合計 35.8s）。
    SIM7080G HW Design §3.2.2 が正式な電源断として挙げる AT+CPOWD=1 だけに
    し、電源断後の AT 無応答確認も 3s → 0.5s に短縮する。AT+CPOWD=0
    （緊急電源断）は、フラッシュ保護の裏付けが資料にないため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
2026-09-29 docs(#74): ブラウンアウト調査の結論をまとめ、README と関連ドキュメントを最新化
    - docs/74-brownout-conclusions.md を新規作成（結論のみ。経緯は #74）
    - README: 電源方針（§6）を最新の実測と方針だけに整理。通信方式（§4）、
    BOM（§5）、次のステップ（§10）、リポジトリ構成を現状に合わせる
    - firmware/README: 現在の構成・動作・env・resetReason の意味に書き直し、
    2026-07 時点の実測表や将来構想を削除
    - hardware.md: 給電経路の説明を結論に合わせ、#76 修正後の実測で稼働日数を
    再試算
    - power-measurement.md: チェッカーの差し込み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
2026-09-29 docs(#74): 計測の途中結果（起床ごとの表・シリアルログ）を残す
    U200 高速ロガーの生の CSV は git の管理外で、ローカルリポジトリを消した
    際に失われた。解析の途中結果（find_dips.py の出力）と、#76 の原因特定・
    修正確認に使った XIAO のシリアルログを tools/power-logger/results/74/ に
    保存し、結論ドキュメントからリンクする。
2026-10-01 feat(#40): Grove Wio-E5 の AT ドライバと疎通確認用 env を追加
    - wio_e5.{h,cpp}: 行単位の AT 送受信、LOWPOWER 復帰、probe、USB シリアル素通し
    (AT+KEY / +KEY: はログで伏せ字)
    - xiao-s3-lorawan-test env と PSS_LORAWAN_ENABLED / PSS_LORAWAN_TEST_MODE を追加
    (LTE-M と Grove UART を共有するため static_assert で排他)
    - wiring.md / hardware.md / firmware/README.md / dev-commands に Wio-E5 を追記
2026-10-01 feat(#40): Wio-E5 の OTAA Join と 11 バイトのコアペイロード送信を追加
    - wio_e5: 電源投入時用のプロビジョニング (JP920 / LWOTAA / RETRY 1 / PORT 1 /
    AppEUI・AppKey)、AT+JOIN、confirmed 送信 (AT+CMSGHEX) と応答の解析
    - lorawan_payload: fPort 1 / ver 1 の固定 11 バイトエンコーダ
    (AS923 DR2 dwell の上限に static_assert で収める)
    - lorawan-test env に ~p/~c/~j/~s のテスト用コマンドを追加
    - tools/lorawan: decode.py (Destination の JSON にも対応) とテストベクタ、pytest
    - docs/40-lorawan-design.md: 設定値・ペイロード・実機での実測・届くメッセージ形式
    実機: Join 6.0s、Join 済み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
2026-10-01 feat(#40): LoRaWAN をファームの通常サイクルとブートモードに統合
    - transport: TransportKind::kLoRaWan、connectLoRaWan (未プロビジョニングなら
    JP920 等を設定してから毎回 AT+JOIN)、publishUplinkConfirmed、
    disconnectTransport で毎サイクル AT+LOWPOWER
    - プロビジョニングはタイマー以外の起動後の最初の接続で1回だけ
    (設定コマンドは Join セッションを消すため。成功するまで電波を出さない)
    - main: sendReasonFor() を mustPublish() から切り出し、LoRaWAN のときは
    11 バイトのコアペイロードで送信 (JSON はシリアルログ用に維持)。
    Deep Sleep 前に esp_d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
2026-10-01 feat(#40): LoRaWAN のコアペイロードに threshold を追加 (13 バイト化)
    - lorawan_payload: バイト 11-12 に判定閾値 (uint16 BE、0-65535 に収める)。
    上限の static_assert を DR2 の dwell time 無効時 (51B) に変更
    - AWS IoT Core for LoRaWAN は TxParamSetupReq で dwell time を OFF に指定してくる
    ことを実機で確認 (AT+LW=TPS が Join と送信の後も OFF, OFF)
    - wio_e5: "Length error" をエラーとして扱う (dwell 有効なネットワークの DR2 など)
    - decode.py / test_vectors.json / pytest を 13 バイトに更新
    - docs: dwell time の確認結果、ARIB の送信時間の未確認事項、MaxEIRP の注意
    実機: DR2 (SF1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
2026-10-01 feat(#40): LoRaWAN のペイロードに bootCount / resetReason / wakeCause を追加 (18 バイト化)
    iOS ログビューアがブート回数とリセット検知に使う power.bootCount /
    power.resetReason / power.wakeCause を、クラウド側で LTE-M 版と同じ形の JSON に
    揃えられるようにする。
    - バイト 13-16: bootCount (uint32 BE、RTC の起床回数)
    - バイト 17: wakeCause (上位 4bit) / resetReason (下位 4bit)。
    文字列は resetReasonToString / wakeCauseToString と同じ並び
    - decode.py は power オブジェクト ({bootCount, resetReason, wakeCause}) を出す
    - test_vectors.json をエンコーダの出力から作り直し、docs と READM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
2026-10-01 feat(#83): LoRaWAN のアップリンクを LTE-M 版と同じ JSON にそろえ、iOS ログビューアに出す (#84)
    * feat(#83): LoRaWAN のアップリンクを LTE-M 版と同じ JSON にそろえて iOS ログビューアに出す
    - IoT ルール parking_status_lorawan（lorawan/parking-status/uplink → Lambda）を
    infra/setup.sh に追加（冪等）。verify.sh も対応
    - bridge/lorawan.py: WirelessMetadata.LoRaWAN を判別し、18 バイトのコアペイロードを
    デコードして LTE-M 版と同じ形の JSON にする。deviceId は GetWirelessDevice の Name
    （コンテナ内キャッシュ）。生メッセージは "lorawan uplink raw" で別にログ出力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
2026-10-02 fix(#85): 詳細ログ画面をLazyVStackにしてフリーズを解消
    ScrollView直下が通常のVStackだったため、ログ件数が多いデバイス
    （fetchDeviceLogsはデフォルト最大200件）の詳細画面を開くと、画面外
    の分も含めて全カードを一度に構築・レイアウトしていた。各カードは
    色スウォッチ描画とJSONパースを伴うため、ログ件数が多いほど開いた
    瞬間の負荷が大きく、フリーズして見えていた。
    LazyVStackに変更し、表示される分だけ遅延構築されるようにする。
    Closes #85
2026-10-02 docs(#87): LTE-M 無応答時のウォッチドッグ再起動ループ対策の実装計画
    接続の制限時間を二段（soft/hard）で守り、リレーあり環境では AT に応答しない
    モデムを約30秒で諦めて Deep Sleep する。task_wdt 起動時は送信せず失敗として
    記録する。実装は未着手（計画のみ）。
2026-10-02 docs(#90): リレーの定格電圧と #63 の調査結果を訂正
    - docs/25 §2.2: 「制御電圧 3.3V/5V」を訂正。リレーは 5V 定格で、3.3V 駆動は
    定格外（SET 側は特に余裕が薄いという見積り。実測は未確認）。LED が光っても
    コイル通電の証拠にならないことを追記
    - docs/60 §10.1: #63 の「Hi-Z で部分発火」仮説が回路モデルでは再現しないこと、
    SIG にプルダウンを足す案は逆効果になりうることを追記（実機未確認）
    - relay.h / config.h: コイル通電幅は基板側の RC で決まり、PSS_RELAY_PULSE_MS は
    決めないことをコメントに反映（コードの変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
2026-10-02 docs(#91): LoRaWAN 版の消費電力の実測と、制限時間まわりの静的確認を記録
    U200 高速ロガーで xiao-s3-lorawan-pot を約 47 分測り、Deep Sleep（ポットあり
    0.847 mA / なし 0.487 mA）、起床 1 回（送信なし 0.053 mAh / 送信あり 0.073 mAh）、
    1 日の電荷と電池日数を記録した。Join と失敗時は未測定。
    あわせて、connectTransportWithRetry と LoRaWAN の Join・送信が制限時間を試行の
    開始前にしか確認しない点をコードで確認した。ファームの変更は #87 の実装後に別 PR。
2026-10-02 docs(#91): 起床サイクルの約 4.5 秒の原因（推定）と #94 への参照を追記
    波形の長さとコードの待ち（waitForSerial 最大 3,000 ms、initSensor の
    delay(1500)）が一致するため、これを原因と推定して記録した。対応は #94。
2026-10-02 docs(#91): #94 の検証結果（waitForSerial 削除後）と電源投入直後の Join を追記
    waitForSerial の 3 秒を外すと、送信ありの起床が 6.7 s / 0.0728 mAh から
    3.8 s / 0.0437 mAh に下がった（見積りと約 4 % 以内で一致）。電源投入直後の
    Join とプロビジョニング、最初の送信の超過電荷は約 0.016 mAh。送信なしの
    起床と、再 Join・失敗時は未測定。
2026-10-02 docs(#91): waitForSerial 削除後の「送信なし」起床の実測を追記
    送信なしの起床は 5.2 s / 0.0531 mAh から 2.2 s / 0.0243 mAh に下がり、
    見積りと一致した。1 日は約 27.5 → 約 19.2 mAh、電池日数は約 144 → 約 206 日
    （自己放電と使えない領域は未考慮）。次の候補（initSensor の待ち、AT+LOWPOWER、
    Deep Sleep の内訳）を併記した。
2026-10-02 docs(#91): initSensor の待ちを 100 ms にした後の起床の実測を追記
    送信なしの起床は 2.2 s / 0.0243 mAh から約 0.8 s / 0.0105 mAh に下がり、
    見積りと一致した。1 日は約 19.2 → 約 15.2 mAh、電池日数は約 206 → 約 260 日
    （#94 前の約 144 日の約 1.8 倍。自己放電と使えない領域は未考慮）。
    Deep Sleep が 1 日の約 77 % になったため、次の候補を更新した。
2026-10-02 perf(#94): 起床サイクルの待ちを短縮（waitForSerial・initSensor）
    起床1回の約4.5秒（約36mA）が「待ち」だった（#91の実測）。
    - waitForSerial: USB接続待ち（最大3秒）を、タイマー復帰では行わない。
    電源投入・USBリセット時は従来どおり。'h' の即時チェックは残す。
    - initSensor: delay(1500) を kSettleMs=100 に。実測（コールドブート、
    満・空 各3回）で、設定書込み後 約37msでG/B/W、約46msでRが有効になり、
    それ以前は全チャネル0を返す。約2.2倍の余裕を見て100ms。
    通電中（タイマー復帰相当）は書込み直後から有効値が読める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
2026-10-02 chore: 消費電力ロガーの生キャプチャ CSV を .gitignore に追加
    tools/power-logger/power-log-*.csv は計測ごとに増える生ログで、
    リポジトリには載せない。追跡済みの capture-phase0-N.csv と
    results/ 配下は対象外。
2026-10-05 feat(#88): LTE-M 電源遮断用ロードスイッチ基板（rev A）の設計と発注記録
    ラッチングリレー（5V コイル品を 3.3V で駆動）の代わりに、TI TPS22918 の
    ロードスイッチを載せた Grove コネクタ 3 つ（IN / OUT / CTRL）の小基板を設計した。
    - hardware/lte-power-switch/: KiCad 10.0.6 のプロジェクト（ERC・DRC 違反 0 件）、
    ガーバー、JLCPCB 用 BOM / CPL、README
    - docs/88-load-switch-design.md: 設計案、TPS22918 の確認済み仕様、ファームの変更案、
    ベンチ確認項目、2026-10-05 の発注記録
    - docs/88-relay-experiment-sheet.md: リレー切り分け実験の記録シート（最小セ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
2026-10-06 feat(#99): 満空判定の値 available を open に統一する
    FIWARE Smart Data Models の OffStreetParking.status の値（full / open）に
    そろえる。Orion 連携（#7）の前に統一しておくことで、将来のマッピングが
    恒等変換になる。unknown と日本語ラベル（満 / 空 / 不明）は変えない。
    - firmware: statusToString を "open" に、列挙名 kAvailable を kOpen に
    - LoRaWAN: 番号 → 文字列の変換表（bridge/lorawan.py, tools/lorawan/decode.py）。
    無線上の値（0/1/2 の番号）は変わらないので端末の再書き込みは不要
    - iOS ログビューア: open を正とし、旧値 available も open として読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
2026-10-06 feat(#98): 組織アカウント移行向けに infra スクリプトを整備する
    個人 AWS アカウントの環境を組織アカウントに再作成するための Phase 1
    （Issue #98）。組織アカウントは Power User 権限で、IAM ロールの作成と
    iam:PassRole ができないため、管理者が用意したロールを使えるようにする。
    - lib.sh: EXPECTED_ACCOUNT_ID を必須にし、クレデンシャルが指すアカウントと
    違えば中断する（旧アカウントと組織アカウントの取り違え防止）。
    AWS_PROFILE の既定値 default をやめ、CONFIG_FILE で設定ファイルを切り替え可能に
    - deploy-bridge-stub.sh / se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
2026-10-06 docs(#14): data-model に name を追加し、デバイスマスターの方針を bridge に記す
    Orion のエンティティに駐車場の名称 name を追加する。name と location は
    端末ではなく、deviceId をキーにしたデバイスマスターから Lambda が埋め込む。
    - docs/data-model.md: name を追加。id は deviceId から生成、location は
    [経度, 緯度] の順であることを明記。利用側に必要な情報（登録のない端末の
    エンティティは作られない、登録内容の反映のタイミング）だけを書く
    - bridge/README.md: デバイスマスターの項目、未登録 deviceId・enabled=false の
    扱い、キ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
2026-10-06 docs(#14): data-model.md の診断フィールド節を bridge/README.md に移す
    data-model.md は Orion エンティティのインターフェース（利用側が参照する情報）に
    絞る。端末が MQTT ペイロードに含める診断項目（sync.* / network.* / bootMode.* /
    pot.*）は Orion に送らない運用診断用の情報で、Lambda 実装側の説明なので、
    bridge/README.md に移す。
    - bridge/README.md: 「MQTT ペイロードの診断項目」として移動（リンクを bridge/ からのパスに修正）
    - docs/60-potentiometer-threshold-design.md: 旧位置を指していた参照を更新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
2026-10-06 fix(#98): verify-cognito.sh の判定を直し、setup-lorawan.sh に --no-destination を追加
    組織アカウントで Power User 権限のまま実際に進めて見つかった点を直す。
    - verify-cognito.sh: 「Identity Pool roles attached」が、ロールが無いときも OK に
    なっていた。ロールが無いと --output text が文字列 None を返し、`grep -q .` を
    通っていたため。arn:aws:iam:: で始まるときだけ OK にする（#68 からの不具合）
    - setup-lorawan.sh: profiles に --no-destination を追加。Destination は IAM ロールが
    要るので、管理者のロールを待つ間に、ロール不要の Service Profile / Device Pro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
2026-10-06 docs(#14): data-model.md から「将来対応」の節を削除する
    絞る。OffStreetParking へのマッピングの将来計画（対応表、unknown をマッピング
    しない、refParkingLot での紐づけ）は、実際に実装するときに設計し直すため削除する。
    - 「将来対応: OffStreetParking へのマッピング」の節を削除
    - 設計方針の「OffStreetParking へのマッピングは将来フェーズで対応する」を削除
    - status 値の注記から、削除した節への参照を外す
    unknown は status 値の定義に残す（エ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
2026-10-06 docs(#14): data-model.md のエンティティ例を佐賀市役所第1駐車場にする
    エンティティ例と name の説明の例を「サンプル駐車場 1階」から
    「佐賀市役所第1駐車場」に変え、location も同じ地点（経度 130.3008、緯度 33.2629）
    にそろえる。
2026-10-06 docs(#14): data-model.md に「更新のタイミング」を追加する
    エンティティがどのように更新されるかを、利用側が参照できるように書く。
    - 約 5 分ごとに読み取り、status が変わったらその周期のうちに upsert
    - 変化がなくても約 1 時間ごとに強制更新（dateObserved が進む）
    - status が変わらない限り、rawSensor だけの変動では更新されない
    - 通信失敗時は次回以降の周期で再送。更新のたびに全属性を書き込む
    - 利用側の目安として、90 分以上更新がなければ端末の停止・通信不良の可能性
    値はファームの設定（PSS_SLEEP_SECONDS=300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
2026-10-06 feat(#7): Lambda ブリッジに Orion への NGSIv2 upsert を実装する
    - ngsi.py: テレメトリ → ParkingStatusSensor エンティティの変換（診断項目は含めない、旧 status=available を open に正規化）
    - orion.py: POST /v2/entities?options=upsert（5 秒タイムアウト、ネットワーク障害・5xx は即時リトライ 1 回）
    - cognito_auth.py: Orion 用トークンを、送るたびに Cognito（SRP）で取得する。標準ライブラリのみ
    - device_master.py: deviceId → name / location を DynamoDB から引く（5 分キャッシュ、失敗時は古い値を使う）
    - handler.py: ログ出力 → Orion upsert の順。Orion 側の失敗・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
2026-10-06 feat(#7): デバイスマスターのテーブルと Orion 接続設定を infra スクリプトに追加する
    - setup-device-master.sh: DynamoDB テーブル作成（プロビジョンド 1 RCU / 1 WCU）。setup.sh から呼ぶ
    - device-master.sh: 端末の登録・一覧・取得・削除
    - deploy-bridge-stub.sh: Lambda の環境変数（DEVICE_MASTER_TABLE / ORION_*）と実行ロールの dynamodb:GetItem を設定。
    Cognito のパスワードはファイルに書かず、デプロイ時に入力するか設定済みの値を引き継ぐ
    - verify.sh: テーブル・権限・Orion 設定の確認（パスワードは表示しない）
    - bridge/README・infra/README・aws-admin-handof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
2026-10-06 docs(#88): ポテンショメーターは「ブートモード後に抜く運用」に決定
    ロードスイッチ基板に替えると、リレーの 2ch でポットの VCC を切る方式が使えなくなる。
    docs/60 §2.7（v5）の運用（ブートモード中だけつなぎ、値は NVS に保存して抜く）を
    そのまま使う。ファームの変更は不要。抜き忘れると待機電流が約 0.3mA 増える点と、
    抜いたあとの物理的な電源サイクルの注意を設計書に追記した。
2026-10-06 docs(#88): DFM 分析の結果を発注記録に追記
    実装される部品は 7 点すべてで警告なし。U1 の 1 点だけ JLCPCB 側で修正され、
    修正後の最終配置で J1〜J3 と U1 の pin1 が設計と一致していることを確認した。
    CPL の U1 の回転角は補正が要る可能性があるため、rev B の注意点として残した。
2026-10-06 feat(#98): setup-lorawan.sh に role を追加し、LoRaWAN 用 IAM ロールをスクリプト化する
    Destination とゲートウェイ（CUPS）が使う IAM ロール IoTWirelessGatewayCertManagerRole は
    これまでコンソールが自動作成していて、スクリプト化されていなかった。管理者から
    AdminAccess が付与されたので、スクリプトで再現できるようにする。
    - setup-lorawan.sh role: ロール（パス /service-role/）を docs/aws-admin-handoff.md の
    定義どおりに作る。信頼ポリシーは iotwireless.amazonaws.com、管理ポリシーは
    AWSIoTWirelessGatewayCertManager、インラインポリシー parking-status-lora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
2026-10-07 fix(#105): パワーロガーの mAh 積算を長期測定向けに直す
    - 積算を float から整数（µA·ms, uint64_t）に変更。64 mAh 以上の誤差と
    128 mAh での頭打ちを解消
    - millis() の 1 周（約 49.7 日）で積算が途切れないようにした
    - 60 秒ごとに CSV ヘッダーと `# total,...` 行を出力（通常・高速モード共通）
    - 高速モードの OLED に積算 mAh を表示
    - integrate_mah.py: ヘッダー無しログでも列数から電流列を選ぶ、
    通常モードのヘッダーに対応、ms 列の 1 周を扱う
    - README に長期測定の節を追加
2026-10-07 feat(#98): iOS ログビューアの接続先を組織アカウントに切り替える
    LoRaWAN と M2 ゲートウェイの新アカウントへの切り替えが終わり、LoRaWAN 端末の
    ログが新アカウントの CloudWatch Logs に出るようになったため、アプリの接続先を
    個人アカウント（parking-private）から組織アカウントに切り替える。
    - Config.swift: Cognito の User Pool ID / App Client ID / Identity Pool ID を
    新アカウントの値に変更（AWS の API から取得して反映）。コメントも更新
    - docs/ios-app-cognito.md: 「作成した AWS リソース」の見出しを更新
    LTE-M 端末は、LTE-M の切り替え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
2026-10-07 feat(#108): iOS ログビューアで deviceId の代わりに駐車場名を表示する
    デバイスマスターの DynamoDB テーブルをアプリが直接読み、駐車場名（name）を
    主表示にする。deviceId は障害の切り分け用に補助表示として残す。
    AWS 側（infra/）:
    - Cognito の認証済みロールに、デバイスマスターのテーブルだけを対象にした
    読み取りのインラインポリシー device-master-readonly（dynamodb:Scan / GetItem）
    を追加。setup-cognito.sh が付け、verify-cognito.sh で確認する
    アプリ側（tools/log-viewer/）:
    - DeviceMasterService: DynamoDB の Scan を、既存の Cognito 認証情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
2026-10-07 docs(#98): 組織アカウントへの移行（Phase 7）に合わせてドキュメントを更新する
    当初は「管理者が構築して引き渡す」前提で書いていたが、実際は、組織がこの PoC 専用の
    アカウントと SSO 権限を用意し、開発チームが infra/ のスクリプトで構築した。
    それに合わせて、ドキュメントを実際の構築内容に更新する。
    - aws-admin-handoff.md: 冒頭に現状を明記。役割分担と、ReadOnly / PowerUser / Admin の
    使い分けを追加。リソース一覧に Cognito・LoRaWAN・ロールを追加。手順を config.org.env /
    EXPECTED_ACCOUNT_ID / SSO に合わせて更新。引き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
2026-10-07 feat(#98): Lambda のロググループの保持期間を設定する（400 日）
    ロググループは Lambda の最初の実行で自動的に作られるが、保持期間は無期限のままだった。
    スクリプトで設定できるようにし、約 1 年（400 日）にする。
    - lib.sh: LOG_RETENTION_DAYS（既定 400）と ensure_log_retention を追加。ロググループを
    （無ければ作って）保持期間を設定する。冪等。LOG_RETENTION_DAYS を空にすると設定しない
    - setup.sh: IoT ルールの作成のあとに ensure_log_retention を呼ぶ
    - verify.sh: 保持期間が設定値どおりかを確認する
    - config.env.example、infra/README.md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
2026-10-07 feat(#88): ロードスイッチ基板用のレベル駆動を追加（PSS_LTE_POWER_SWITCH_LEVEL）
    LTE-M の電源遮断を、ラッチングリレーから TI TPS22918 のロードスイッチ基板
    （hardware/lte-power-switch/）に替える機体用に、コンパイル時フラグで
    レベル駆動（HIGH で ON、LOW で OFF）に切り替えられるようにする。
    - config.h: PSS_LTE_POWER_SWITCH_LEVEL（既定 0）を追加
    - relay.cpp: フラグが 1 のとき、起動時の安全パルスを送らず、LOW（OFF）にする。
    relayLteOn() は HIGH、relayLteOff() は LOW。ON ピンは基板上の 100kΩ プルダウンで
    リセット・Deep Sleep・電源喪失のど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
2026-10-07 fix(#87): LTE-M が応答しないときウォッチドッグ再起動ループに入らず Deep Sleep する
    LTE-M モジュールが AT に応答しない（電源が来ていない等）と、接続の制限時間が
    試行の間でしか確認されず、モデム初期化の再試行（約169s）がウォッチドッグ（95s）を
    超えて再起動を繰り返し、Deep Sleep せずに電池を消耗していた。
    - 接続の制限時間を二段にした。soft（PSS_CONNECT_PHASE_MS）は新しい試行を始めるかの
    判断だけに使い、hard（kConnectHardMs = min(soft + 10s, kCycleMaxActiveMs)）で実行中の
    AT 待ち・delay・waitForNetwork・plan-D 設定を縮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
2026-10-07 docs(#40): ARIB STD-T108 のキャリアセンス時間について、調査結果と安全側の対応を追記
    Seeed の仕様書にキャリアセンス時間の記載がないこと、参照実装 LoRaMac-node の
    2 つのチャネル計画（5ms で dwell 制限なし／128µs で 400ms 制限）、実機の周波数が
    両方に入るため確定できないことを §3 に記載。§7 の宿題を更新した。
2026-10-07 docs(#3): Grove センサ用ケースの 3mf を取り込み、帰属表示を追加
    印刷に使っている Seeed Grove Flame Sensor Case（作者 Fyrby Additive、
    CC BY 4.0）の 3mf を hardware/flame-sensor-case/ に配置し、
    出典・作者・ライセンスを README に明記した。
    余計な穴などの形状改善は今後の課題。遮光効果は現場に左右されるため
    ケース・バイ・ケースで確認する方針とし、Issue #3 はクローズ済み。
    Refs #3
2026-10-07 docs(#8): 現場実測（2026-08-25）の RGBC 生値と一次集計を追加
    緑（空）点灯のみの 111 件（10:34〜20:59 JST）を CSV 化し、昼夜別の集計と
    未達項目（満・消灯・深夜）を暫定記録として docs/ に追加する。
2026-10-07 docs(#88): ラッチングリレーを廃止し、ドキュメントをロードスイッチ基板に統一
    5V 定格のリレーを 3.3V レールで駆動していたのは設計上の誤りと判断し、
    最新のドキュメントからリレーの記述をなくして、ロードスイッチ基板（#88）に統一する。
    - README / hardware.md: LTE-M の電源スイッチをロードスイッチ基板に書き換え、BOM を更新
    - docs/25 phase2: §2 を旧方式（廃止）の記録に再構成し、訂正の追記を本文に統合。
    §2.8 に廃止の経緯と教訓を追加
    - docs/60 §11、docs/74、docs/25 前編、docs/88 系: 旧方式であることの注記と状態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
2026-10-12 docs(#88): rev A の実機確認結果（コネクタの鏡像）と rev B の方針を記録
    2026-10-12 に rev A の基板が届き、実機で確認した。
    - J1・J2・J3 の Grove コネクタ（HY2.0-4P-WT）の pad 番号が実物と鏡像だった。
    三角のマークに一番近いパッドに、黒（GND）が来る。回路図は正しく、
    フットプリントの pad 番号が逆。普通の Grove ケーブルでは使えない
    - ケーブルを切って、テストポイントに直結した確認で、ロードスイッチは動作した
    （EN を 3V3 につなぐと VLTE が 3.3V、外すと 1 秒以内に 0V。U1 の向きは正しい）
    - rev B の方針（フッ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
2026-10-12 docs(#88): rev A + LTE-M + 実機ファームでの確認結果を追記
    逆結線の専用ケーブル（基板側のプラグの線の順番を逆にしたもの）で、
    Shield・U128・カラーセンサー・ポテンショメーターをつないで確認した。
    - ブートモードの送信 2/5〜5/5 が、途中でリセットされずに完了した
    （LTE-M の接続、MQTT、QoS1 の送信の確認）
    - OFF のときの VLTE は、UART が動いている間は約 0.76V（旧リレー方式と同程度）。
    Deep Sleep では 20〜30 秒で 0V になった。QOD（R2）は実装しなくてよさそう
    - 未確認: 電圧降下（0.6A）、突入電流の波形、Deep Sleep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
2026-10-12 feat(#88): ロードスイッチ基板 rev B（Grove コネクタの鏡像を修正）
    rev A は、HY2.0-4P-WT のフットプリントの pad 番号が実物と鏡像だった
    （三角のパッドに、Grove ケーブルの黒（GND）が来る）。rev B で直す。
    - フットプリントの pad 番号を逆にした（1↔4、2↔3）。回路図（論理）は変えない
    - コネクタまわりの配線を引き直した。SIG1・SIG2 は裏面の入れ子の U 字。
    U1・C1・C2・R1・R2・C3 と J1〜J3 の位置・向きは rev A と同じ（CPL も同じ）。
    TP2 のみ、VLTE の線の上に移した。テストポイントは rev A のまま
    - 印字: 各コネクタに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
2026-10-12 docs(#88): rev B の発注（2026-10-12）を記録
    - JLCPCB、PCB/PCBA、各 5 枚。注文番号 W2026101217460284、
    商品 $20.90 + 送料 $9.71 = $30.61（rev A は $20.14。新規ユーザーのクーポンの分）
    - 内訳: PCB（Y3-13728224A）$2.00、実装 $20.48
    - 注文画面（PCBA Viewer）で、U1 の pin1 が左上のパッドであることを確認
    - 「未発注」の記述を、「2026-10-12 発注」に更新
2026-10-13 docs(#88): 1 号機の実機（rev A + LTE-M）での動作確認と消費電力の実測を記録
    2026-10-13、1 号機（xiao-e83dc1fb05fc）に xiao-s3-aws-lte-switch-pot を書き込み、
    rev A のロードスイッチ基板で、動作と消費電力を確認した（電力ロガー 20 分）。
    - ブートモードの送信 5 回、状態変化の送信、定期送信（約 66 分ごと）がすべて届いた
    - 待機電流（Deep Sleep）は平均 0.40 mA（旧リレー方式は 0.45 mA）
    - 送信 1 回は 0.42 mAh（LTE の接続 7.5 秒）〜 1.14 mAh（接続 30.5 秒）。
    差は電波の状況によるもので、ロードスイッチによる増加ではない
    - 電圧の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
2026-11-02 fix(#123): 台帳を RTC 主にし、NVS の書き込み失敗で heartbeat が止まらないようにする
    送信台帳（SyncLedger）が NVS のみに保存されていたため、NVS の空きが尽きて
    書き込みが失敗すると、heartbeat のカウンタが進まず、端末が起きているのに
    何も送らなくなっていた（2号機が約11日間無送信、#122）。
    - 台帳の主な保存先を RTC メモリにする（magic + FNV-1a チェックサムで有効性を判定）
    - NVS は電源断に備えたバックアップ。書けたら書く（戻り値を確認し、失敗は件数を
    数えてログに出す。台帳の内容は変えない）
    - 起動時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
2026-11-02 fix(#123): 履歴ログは NVS に空きがあるときだけ書き、他の NVS 利用者を圧迫しない
    履歴ログ（診断用）が NVS の空きを使い切ると、書きかけの blob が毎サイクル残り、
    台帳のバックアップ・ポテンショメーターの値・LTE モデムの TLS フラグなど、同じ NVS を
    使う他の機能の書き込みまで失敗していた（#122、#123）。
    - 書き込み前に nvs_get_stats() で実質の空き（free_entries から書き換え用の予備ページ
    126 を引いた値）を確認し、セグメント 1 回分の最大消費（30）+ ほかの使い手の余裕
    （16）= 46 エントリ未満ならスキップ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
2026-11-02 fix(#123): 履歴ログの既定容量を 480 件（10 セグメント）に減らし、初回書き込みでの NVS 消去を手順化する
    NVS は使えるのが 504 エントリで、履歴ログのセグメント 1 個は 26〜29 エントリを占める。
    14 セグメントでは、firmware が作らない namespace の残り（phy など約 78 エントリ）が
    ある機体で、空きが足りなくなって履歴ログが途中で止まる（#125 の空き確認で、他の機能は
    守られるが、リングが回らず、最初の約 2 日分だけが残る）。
    - PSS_HISTORY_LOG_CAPACITY 672 → 480、PSS_HISTORY_LOG_SEGMENTS 14 → 10
    （約 1.7 日分。「1 日分以上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
2026-11-02 fix(#123): heartbeat のカウンタを NVS にもバックアップし、ブラウンアウトで 0 に戻らないようにする
    ブラウンアウトでは RTC が消え（bootCount が 1 に戻る）、ブートモードは ESP_RST_POWERON の
    ときだけ走る（docs/74）。カウンタを RTC だけに置くと、ブラウンアウトが続くたびにカウントが
    0 に戻り、heartbeat が出なくなる。修正前（NVS に保持）は、連続ブラウンアウトでも数え続けられた。
    - skippedSinceConfirmed を NVS（キー skipn）にもバックアップし、RTC が無効なときの
    復元で読み込む（RTC が主。NVS は書けたら書く）
    - docs/syn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
2026-11-02 fix(#123): 履歴ログの空き確認を、新規作成と上書きで分け、total の書き込み失敗も検知する
    レビューの指摘への対応。
    - 空きの要求を、新しいセグメントを作るとき（46 エントリ = 30 + 余裕 16）と、既存の
    セグメントを上書きするとき（30 エントリ）で分ける。上書きは正味ゼロで、余裕の 16 は
    ログが増えるときだけ要る。全て 46 を求めると、空きが 46 を下回った機体で、リングが
    二度と更新されなくなる
    - total の書き込み（putUInt）の戻り値を確認し、失敗したら total を進めない。セグメントの
    書き込みが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
2026-11-02 refactor(#123): RtcLedger のサイズを static_assert で固定し、未使用の syncLedgerNvsFailures() を外す
    - RtcLedger のチェックサムは構造体の生のバイトに対して計算され、rtcStore() は
    フィールドごとに書く。パディングが入ると未初期化のバイトがチェックサムに入り、RTC の
    コピーが毎回無効になりうる。サイズを static_assert（36 バイト）で固定し、パディングが
    入る変更はビルドで失敗させる
    - どこからも呼ばれていなかった syncLedgerNvsFailures() を外す（失敗の件数は RTC に持ち、
    シリアルのログに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
2026-11-02 fix(#123): 履歴ログのスキップ回数（RTC）に、印となる値による有効性の確認を入れる
    レビューの指摘への対応。skipped_low_space のカウンタは RTC メモリにあり、再書き込みや、
    電源投入以外のリセットのあとに、古い不定のバイトが残る。ダンプに任意の数値が出て、
    実際のスキップ回数と見間違えうる。印となる値（magic）があるときだけカウントを信用し、
    なければ 0 から数える。
2026-11-02 docs(#123): 初回書き込みの手順に、ポテンショメーター版は書き込み後に電源を入れ直すことを追記
    レビューの指摘への対応。ダイヤルの値を読んで NVS に保存するのは、電源投入時の
    ブートモード（ESP_RST_POWERON のとき）だけで、通常のサイクルは保存した値を使う。
    NVS を消去して USB で書き込んだあとのリセットで、ブートモードが走るかは、環境によって
    異なる可能性がある。「次のブートモードで取り直す」だけでは、いつ走るかが分からないため、
    確実に走らせる手順（電源を入れ直す）を明記する。
    Co-Author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
2026-11-02 docs(#123): 初回書き込み後のブートモードとダイヤルの値について、実機で確認した内容を反映する
    2号機で確認した。
    - RESET ボタンを押すと、ブートモードが走り、ダイヤルの値が保存される
    （ブートモード中にダイヤルを回すと、スロットごとに値が追従し、最後の値が NVS に残る）
    - esptool の USB 経由のリセット（upload 直後の自動リセットなど）では、ブートモードは
    走らず、ダイヤルの値は保存されない
    README は、「環境によって異なる可能性がある」としていた箇所を、確認した内容に直し、
    書き込み後の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
2026-11-02 docs(#123): NVS スキーマ表に、heartbeat のカウンタのバックアップ（skipn）を追加する
    レビューの指摘への対応。skipn は、ブラウンアウトで RTC が消えても heartbeat のカウントが
    0 に戻らないよう、NVS にバックアップしているが、§3.1 のスキーマ表になく、表の下の文章で
    しか説明されていなかった。表に行を追加し、表の項目はすべてバックアップであることを明記する。
2026-11-02 docs(#123): 設計書 docs/47 の古い容量の数値（672/14）に、現行の値への案内を入れる
    レビューの指摘への対応。既定容量を 480 件・10 セグメントに改めたあとも、§2.4、§6、§9.3、
    §10 に、672 件・14 セグメント（630 エントリ、セグメント 25 エントリ）が最終値のように
    残り、訂正は §11 にしかなかった。§6 の config.h の例は、実際の config.h と食い違う。
    各節の冒頭に、「(#123 で訂正)」の注記を入れ、現行の値と §11 への案内を示す。
    当時の設計の記録としては、本文を残す。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
2026-11-13 fix(#129): iPad の画面向き宣言に上下逆向きを追加し TestFlight に上げられるようにする
    iPad の multitasking 対応には 4 方向すべての宣言が必要で、不足していると
    App Store Connect へのアップロード検証で弾かれる。
    UISupportedInterfaceOrientations~ipad に PortraitUpsideDown を追加する。
    Refs #129
